vic-simkus/VIOBOARD_V1_Schematics/README.md

# VIOBOARD_V1_Schematics
Schematics for VIOBOAD Version 1.0
