vic-simkus/VIOBOARD_V1_Schematics/BBB_SHIELD_V2/BBB_SHIELD_V2_bom.ods

Sheet: BBB_SHIELD_V2_bom
Description | References | Value | QTY | MFGPN | DKPN
Polarized capacitor | C46 C47 C48 | 180uF,50V | 3 | UPW1H181MPD | 493-1903-ND
Screw terminal, 01x02 | CONN5V5 | Scr Trm 01x02 | 1
Triode | D1 | 24V_TRIAC | 1 | ACTT6X-800E,127 | 1740-1006-ND
Fuse, small symbol | F1 | 24V_IN | 1 | 56000001319 | WK0001-ND
Connector, 01x06 | J2 J3 | Conn_01x06 | 2 | 22052061 | WM4104-ND
Connector, 01x10 | J4 | Conn_01x10 | 1
Connector, 01x04 | J1 | Scr Trm 01x04 | 1
Connector, 02x23 | P8 P9 | BBCONN | 2 |  | A26529-23-ND
VX78XX DC REGULATOR | P12V1 | VX78XX | 1 | VX7805-1000 | 102-4253-ND
VX78XX DC REGULATOR | P5V1 | VX78XX | 1 | VX78012-1000 | 102-4255-ND
N-MOSFET transistor | Q1 | Q_NMOS_GDS | 1 | PHP29N08T,127 | 1727-4645-ND
Push button switch | swP1 swR1 | SW_Push | 2

Sheet: MISC_SMD
DESC | REF |  | Q | MFG_PN | DK_PN
Quad Bilateral Switch | RS232SW | CD74HCx4066 | 2 | CD74HC4066M96 | 296-9224-1-ND
Shunt, adjustable | TL1 | 24V_REF | 1 | TL431BCLPR | 296-17374-1-ND
Current Shunt Monitor | U4 | INA138 | 1 | INA138NA/3K | 296-17936-1-ND
FET DRIVER | U1 | LTC7004 | 1 | LTC7004IMSE | LTC7004IMSE#PBF-ND
Op Amps | U5 | OPA340NA | 1 | OPA340NA/3K | 296-26275-1-ND
MCP1501 | VREF3V1 | SOT-23-6 | 1 | MCP1501T | MCP1501T-33E/CHYCT-ND
Dual RS232 | DRVA1 DRVB1 | MAX3232 | 2 | MAX3232ECDR | 296-19851-1-ND
PIC24FV | PIC1 | PIC24FVXXKA302 | 1 | PIC24FV32KA302 | PIC24FV32KA302-I/SO-ND

Sheet: SMD_DIODE
 | FP | C | MFG PN | DK PN
D9 D10 D11 | COMCHIP_TO_277 | 3 | CDBZ310200-HF | 641-1494-1-ND
D2(TVS) | DO-214AA | 1 | SMBJ26A | SMBJ26ALFCT-ND
D3 | D_SOD-123F | 1 | RF071MM2STR | RF071MM2SCT-ND
D4 D5 D6 D7 D8 LED1 | LED_0805 | 6

Sheet: SMD_CAPS
 | V | F | C | TC | E
C7 C11 C15 C19 | 0.01uF | 0805 | 4 | X7R | 50
C1 C8 C12 C16 C20 C23 C24 C25 C26 C27 C28 C29 C30 C31 C32 | 0.1uF | 0805 | 15 | X7R | 50
C6 C10 C14 C18 C22 | 10uF | 0805 | 5 | X5R | 10
C3 C33 C34 C35 C36 C39 C40 C41 C42 | 10uF | 1206 | 9 | X7R | 50
C2 C4 C5 C9 C13 C17 C21 C45 C49 | 1uF | 0805 | 9 | X7R | 50
C37 C38 C43 C44 | 2.2uF | 1206 | 4 | X5R | 50

Sheet: SMD_RES
 | V | F | C
R9 R10 R13 | 10K | 0805 | 3
R1 R2 R3 R4 R5 R23 | 1K | 0805 | 6
R11 R12 R14 R15 R16 R17 R21 R22 R25 R26 | 200R | 0805 | 10
R6 R24 (0603) | 49K9 | 0805 | 2
R7 R8 R18 R19 R20 | 4K7 | 0805 | 5
RSHUNT1 | 0.01 | 1206 | 1
