vic-simkus/VIOBOARD_V1_Schematics/BBB_SHIELD/SHIELD_CUTLINES_SERIAL_MM_exp.dxf

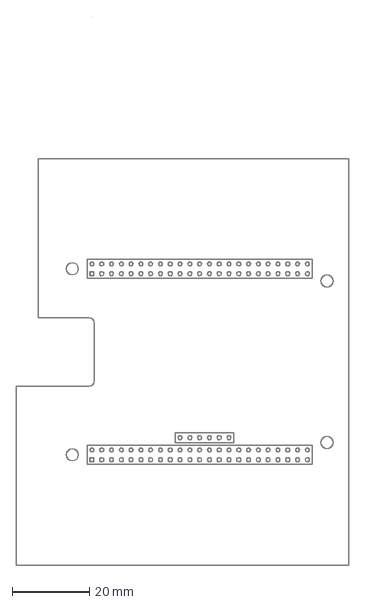
[picture p3: CAD file, 2018-09-03, an earlier design]
BBB_SHIELD/SHIELD_CUTLINES_SERIAL_MM_exp.dxf
86.4 x 142.4 mm
