vic-simkus/VIOBOARD_V1_Schematics/BBB_SHIELD/SHIELD_CUTLINES_SERIAL_MM.dxf

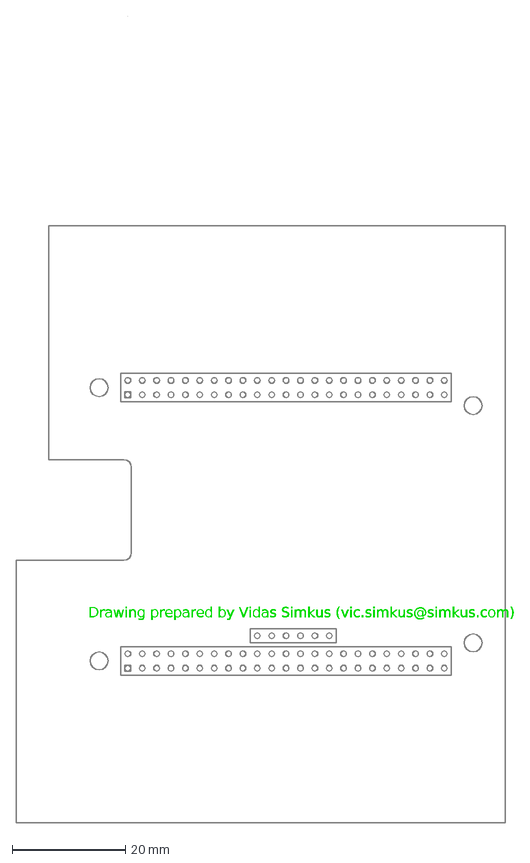
[picture p5: CAD file, 2018-09-03, an earlier design]
BBB_SHIELD/SHIELD_CUTLINES_SERIAL_MM.dxf
Drawing prepared by Vidas Simkus (vic.simkus@simkus.com)
