vic-simkus/VIOBOARD_V1_Schematics/BBB_SHIELD_V2/PLOT_3.0/BBB_SHIELD_V2.pdf

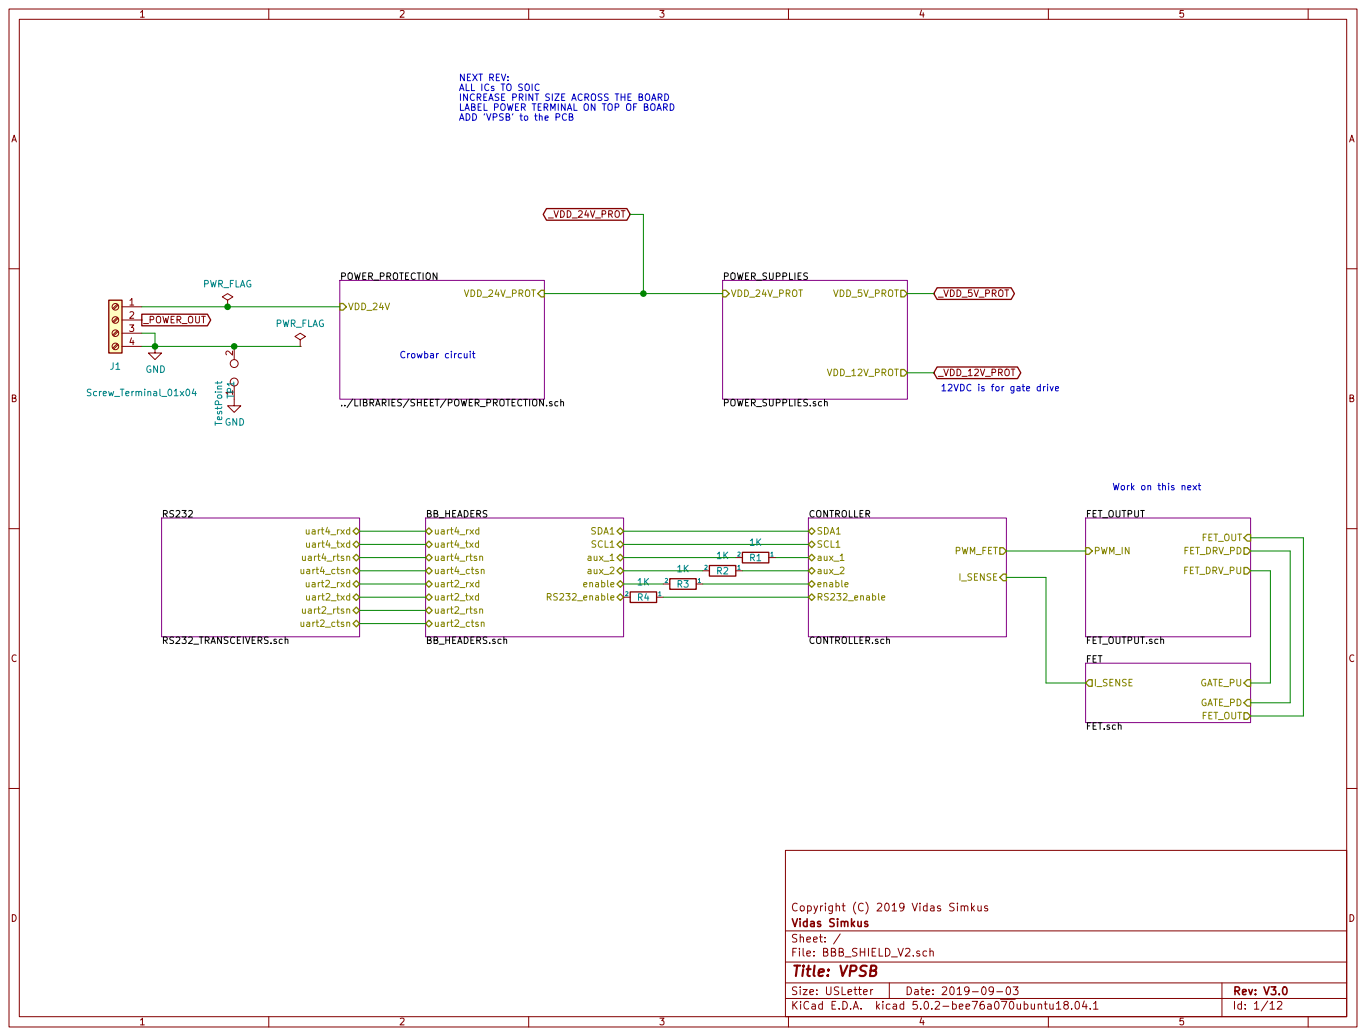
[picture p6: page 1]

NEXT REV: ALL ICs TO SOIC
INCREASE PRINT SIZE ACROSS THE BOARD
LABEL POWER TERMINAL ON TOP OF BOARD
ADD 'VPSB' to the PCB

File: BBB_SHIELD_V2.sch Sheet: / Vidas Simkus Copyright (C) 2019 Vidas Simkus

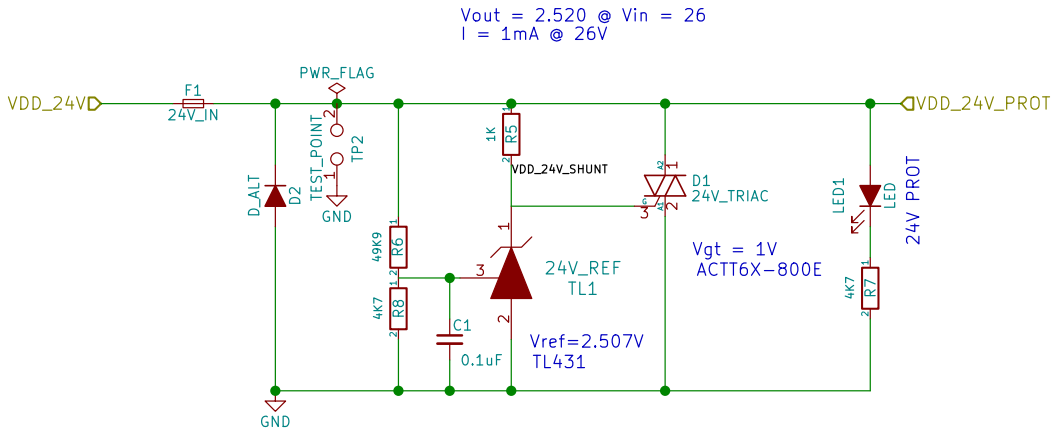
[picture p7: page 2]

Sheet: /POWER_PROTECTION/ Vidas Simkus Copyright (C) 2019 Vidas Simkus

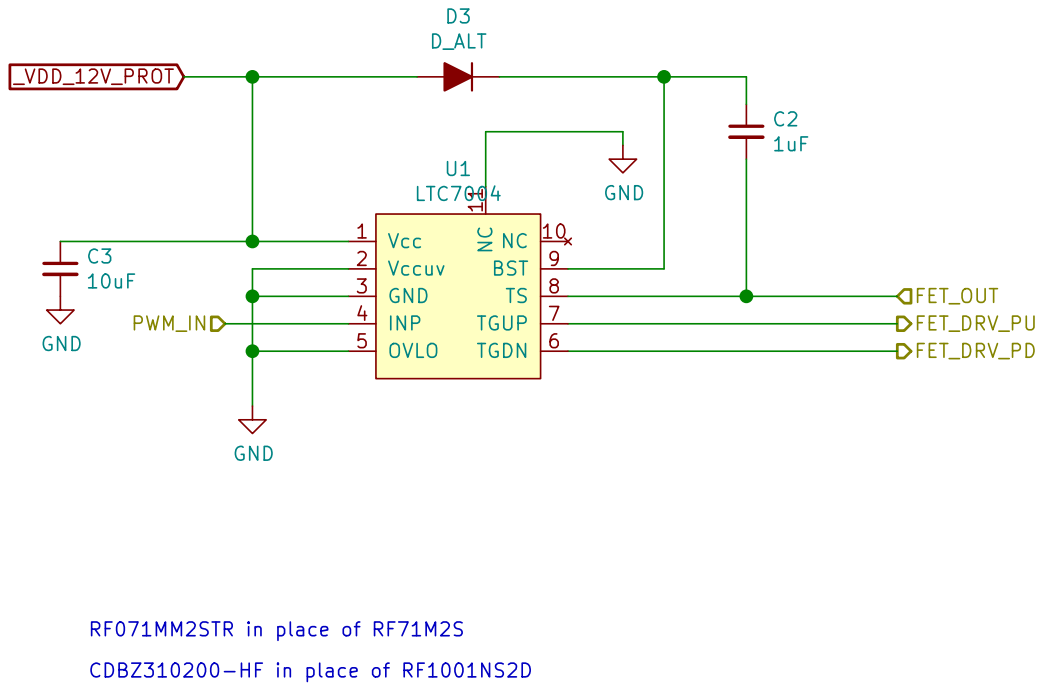
[picture p8: page 3]

RF071MM2STR in place of RF71M2S
CDBZ310200-HF in place of RF1001NS2D

Sheet: /FET_OUTPUT/ Vidas Simkus Copyright (C) 2019 Vidas Simkus

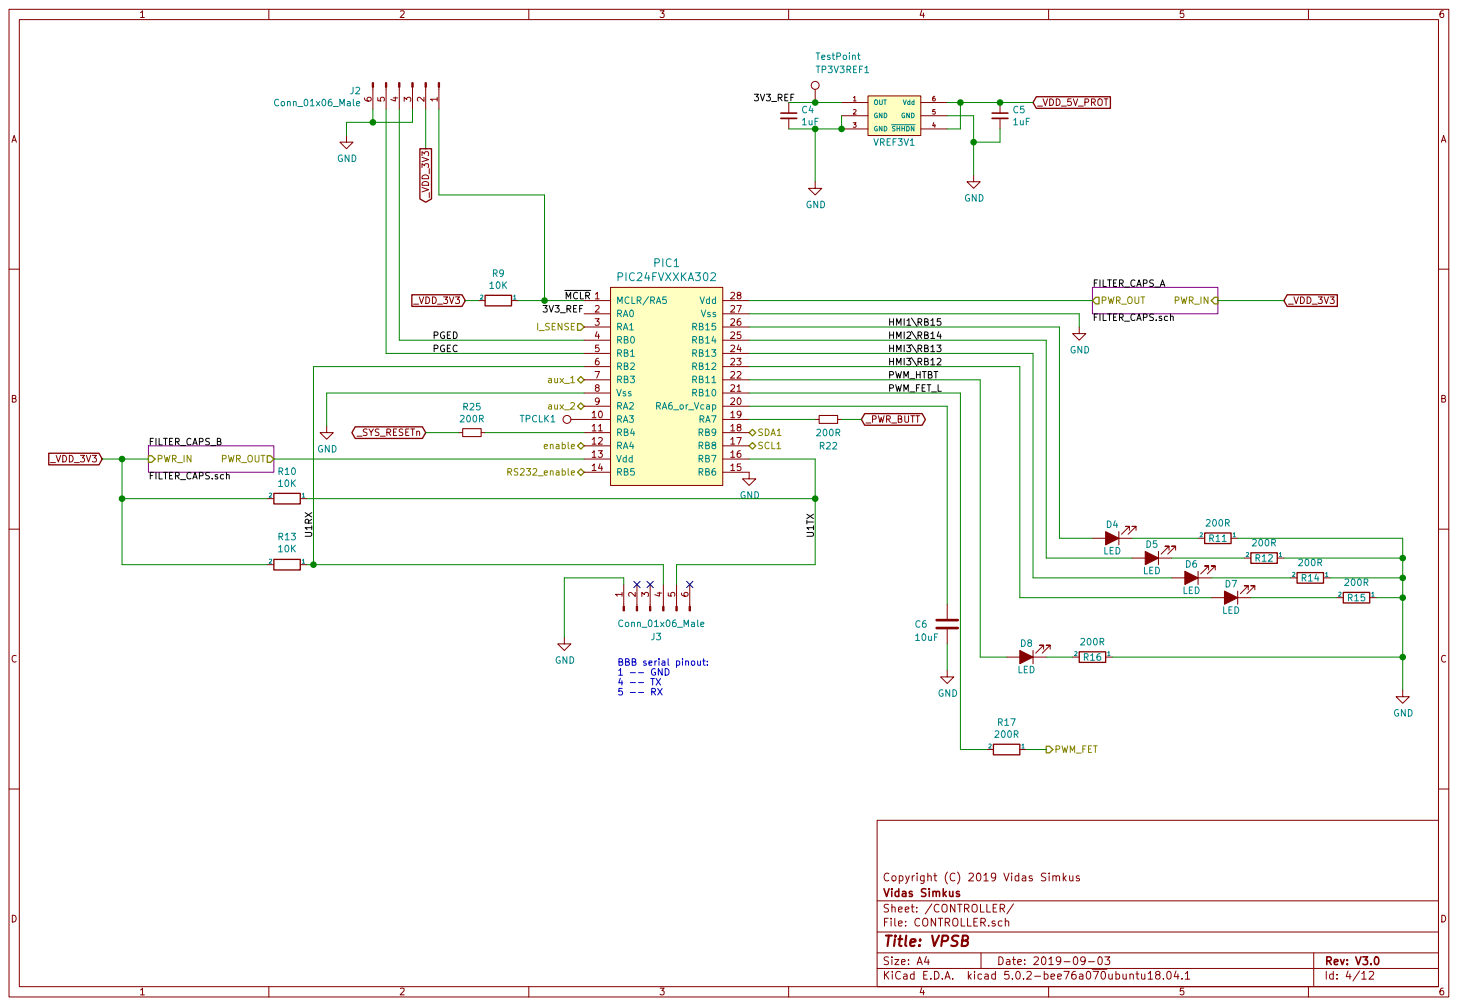
[picture p9: page 4]

BBB serial pinout: 1 -- GND

File: CONTROLLER.sch Sheet: /CONTROLLER/ Vidas Simkus Copyright (C) 2019 Vidas Simkus

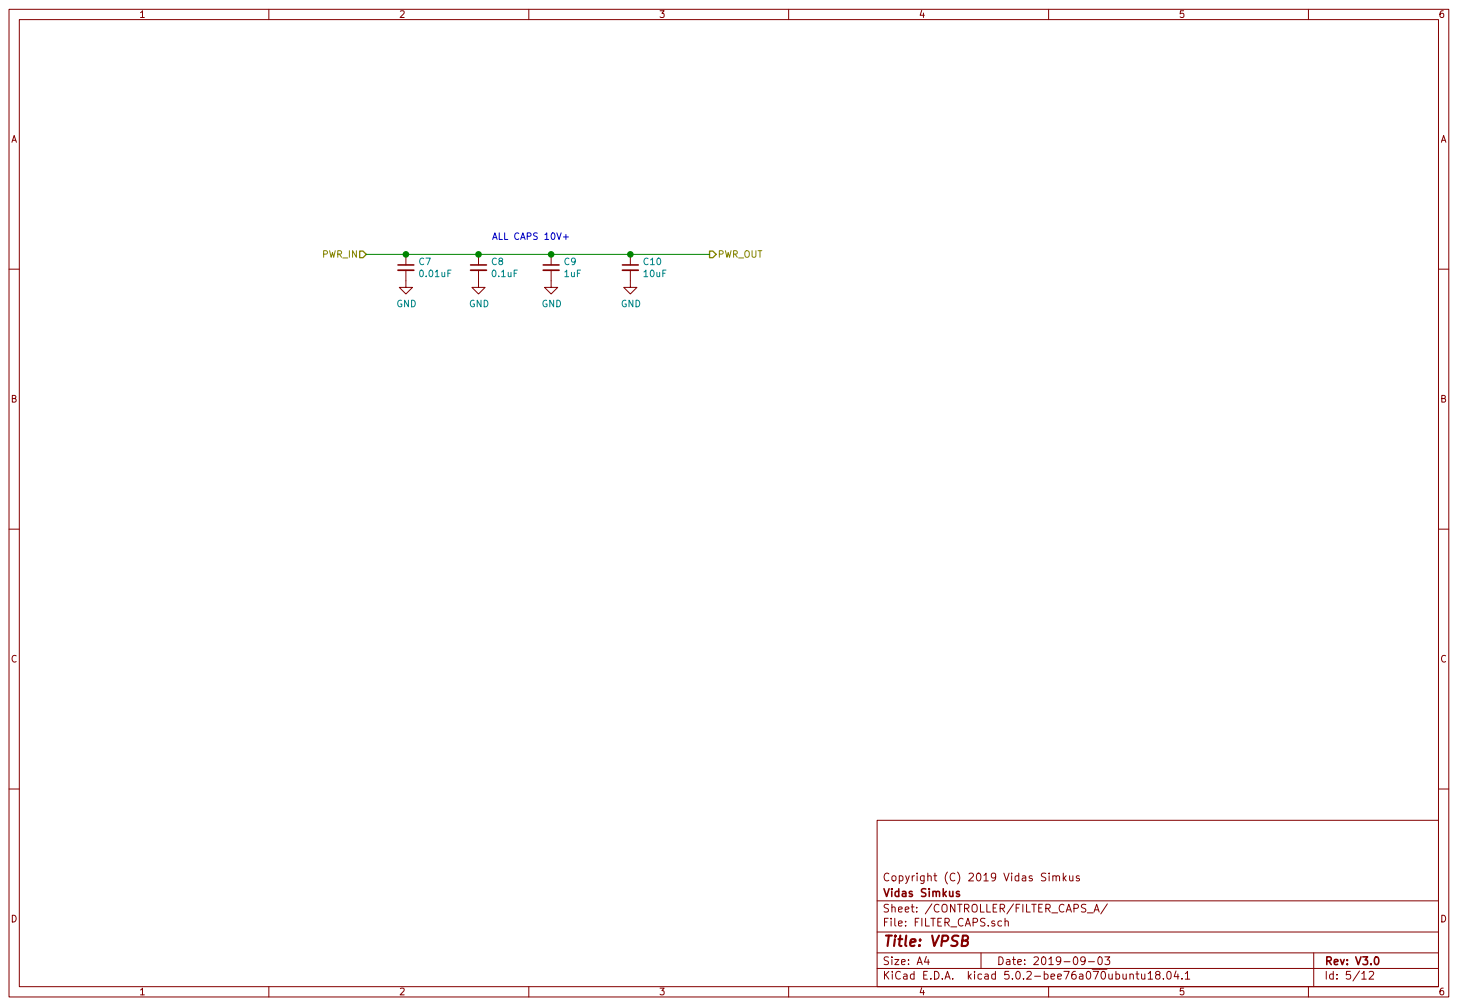
[picture p10: page 5]

Sheet: /CONTROLLER/FILTER_CAPS_A/ Vidas Simkus Copyright (C) 2019 Vidas Simkus

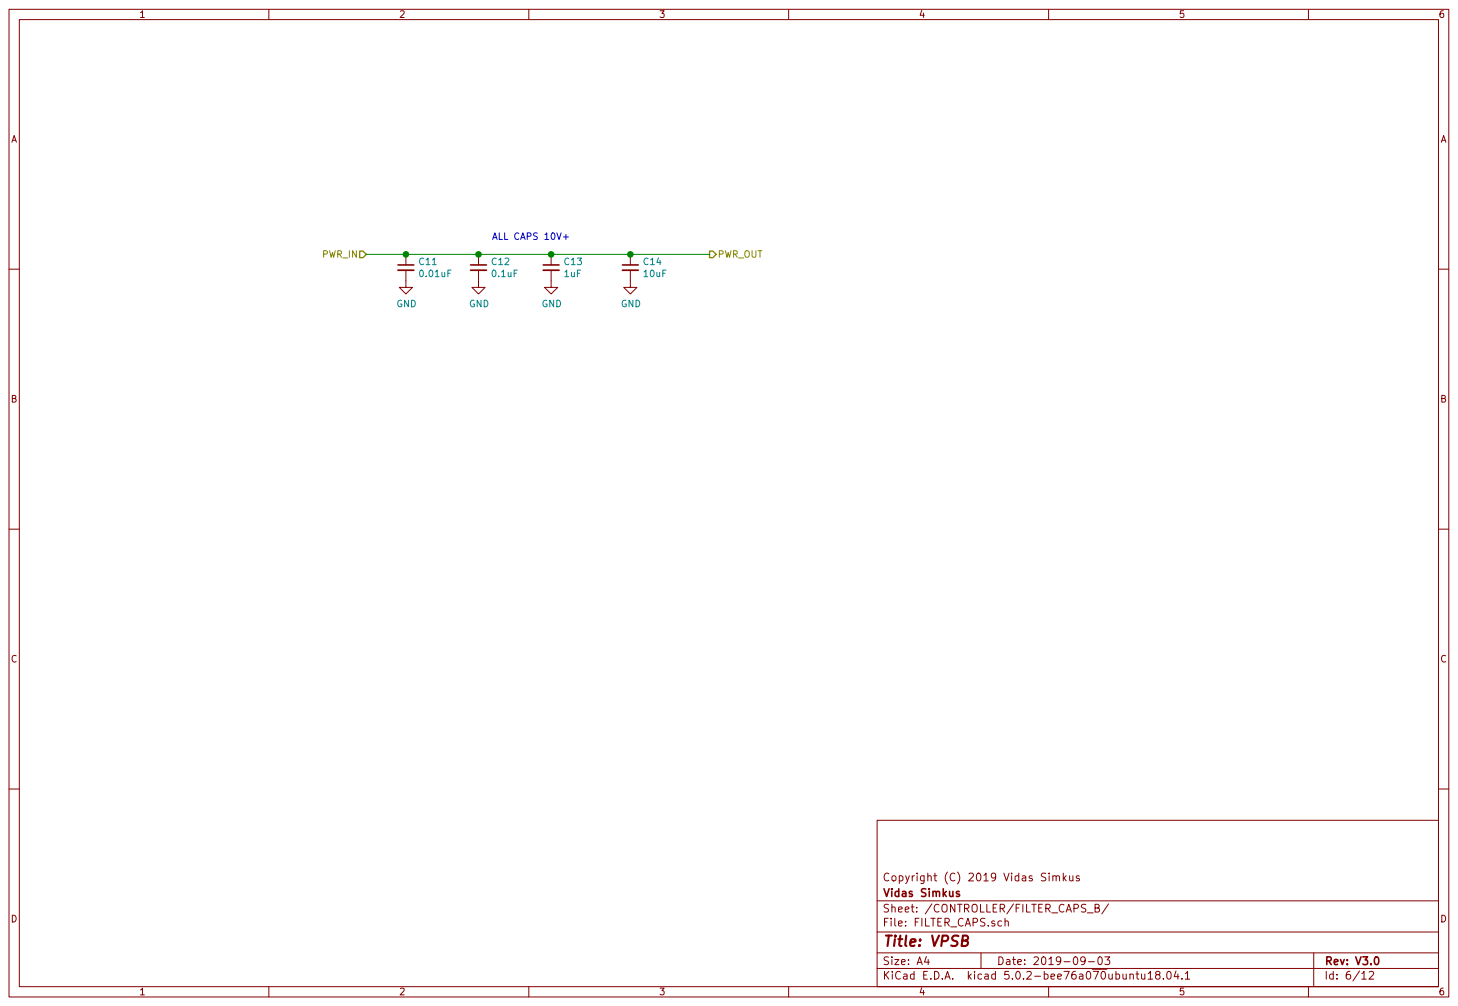
[picture p11: page 6]

Sheet: /CONTROLLER/FILTER_CAPS_B/ Vidas Simkus Copyright (C) 2019 Vidas Simkus

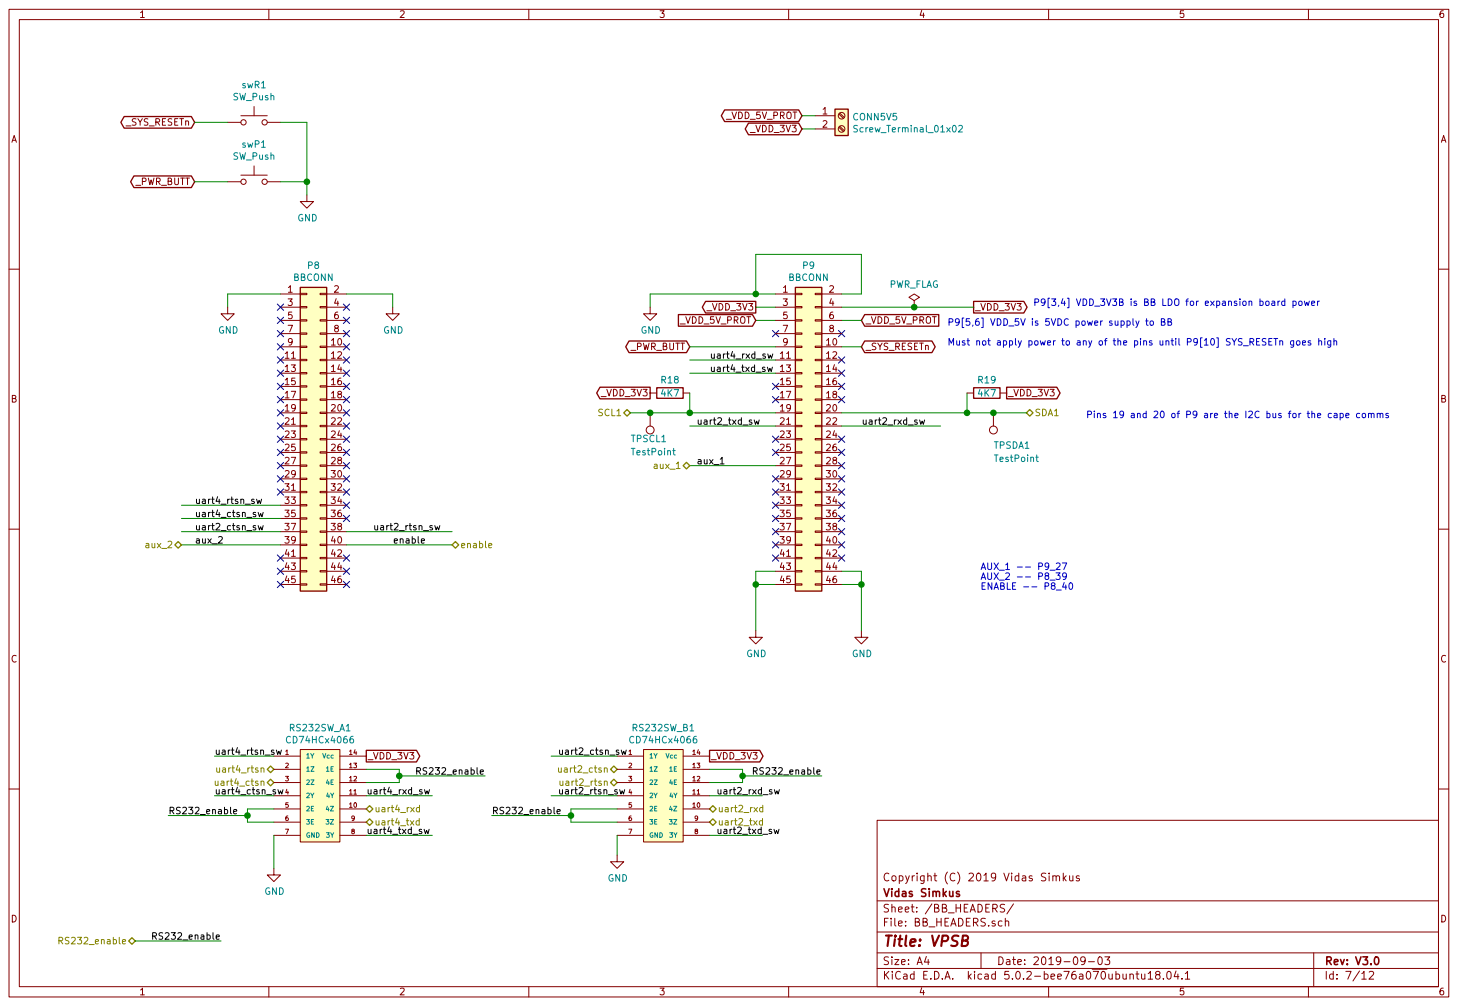
[picture p12: page 7]

P9[5,6] VDD_5V is 5VDC power supply to BB

Sheet: /BB_HEADERS/ Vidas Simkus Copyright (C) 2019 Vidas Simkus

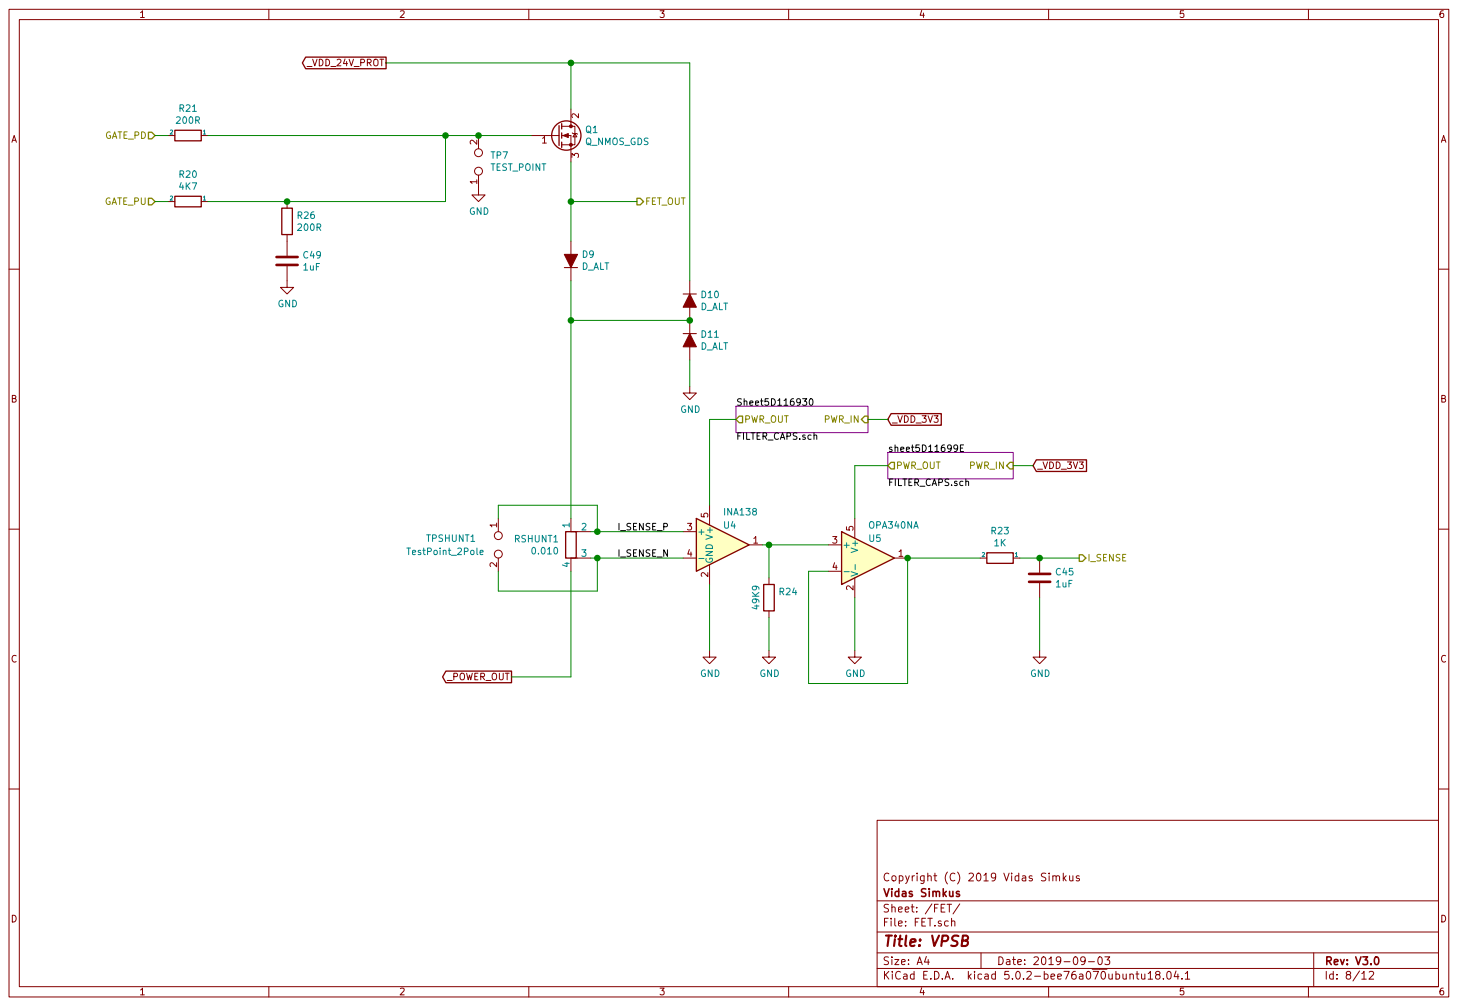
[picture p13: page 8]

File: FET.sch Sheet: /FET/ Vidas Simkus Copyright (C) 2019 Vidas Simkus

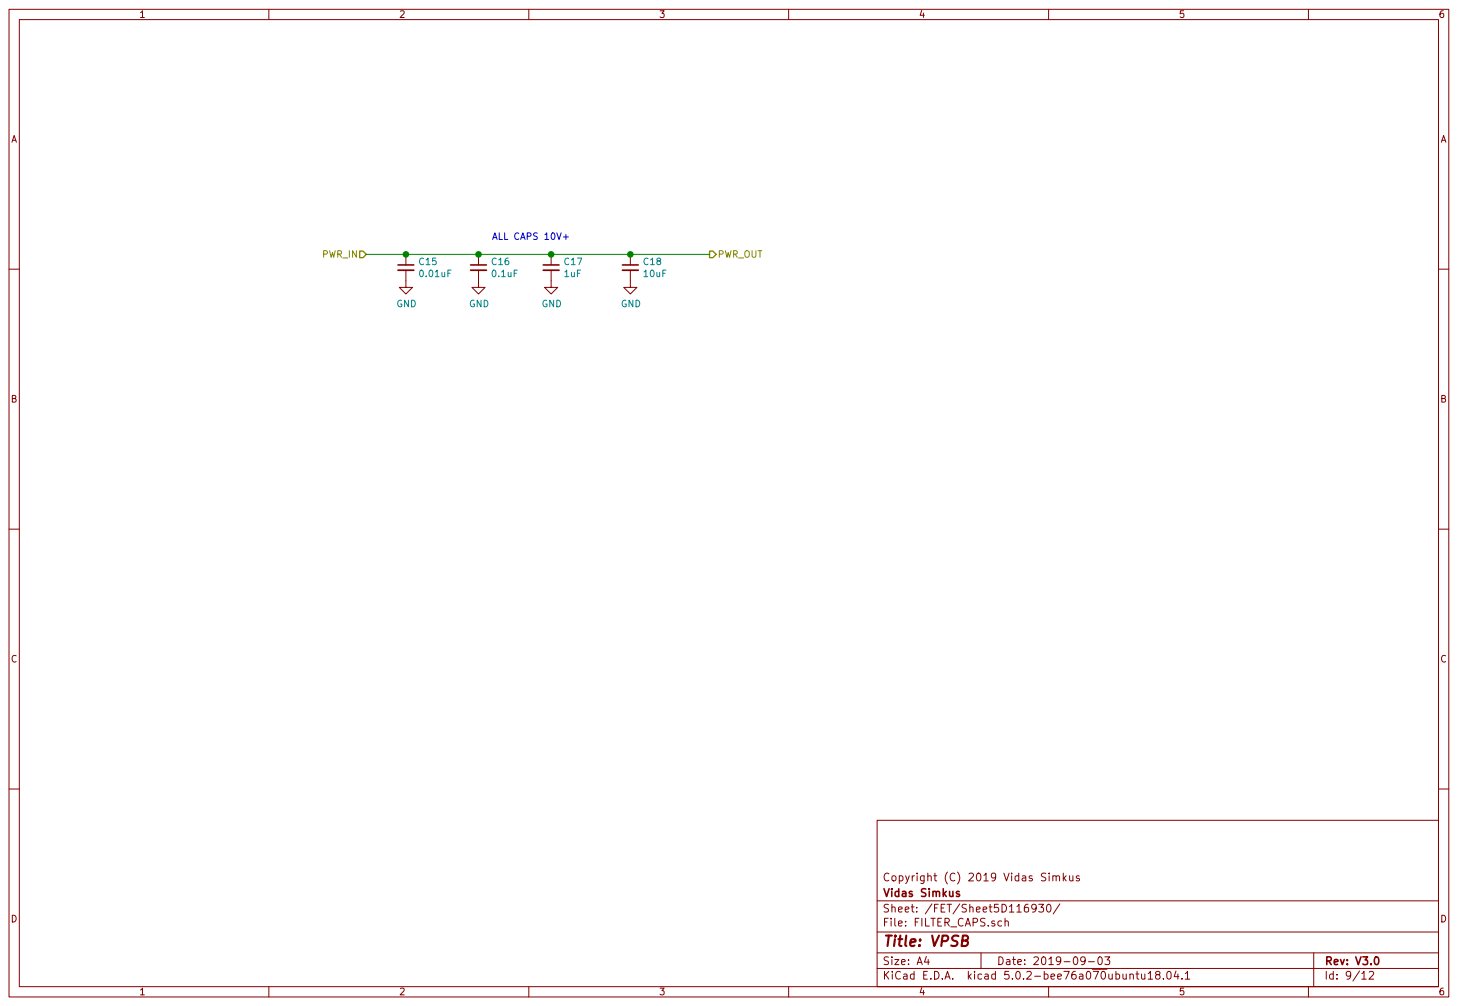
[picture p14: page 9]

File: FILTER_CAPS.sch Sheet: /FET/Sheet5D116930/ Vidas Simkus Copyright (C) 2019 Vidas Simkus

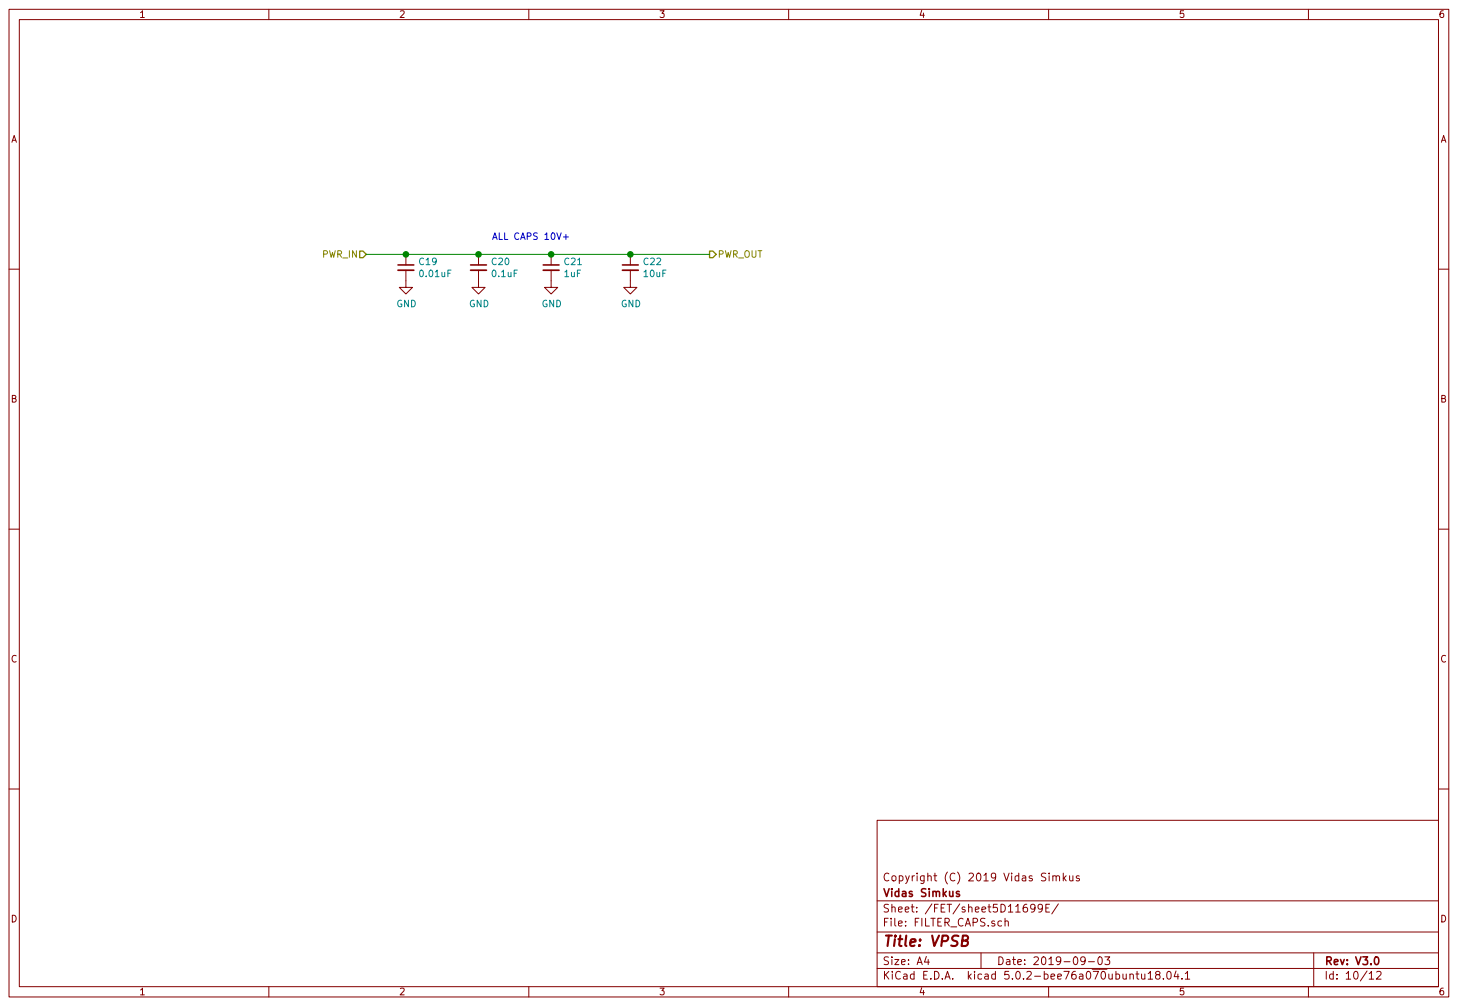
[picture p15: page 10]

File: FILTER_CAPS.sch Sheet: /FET/sheet5D11699E/ Vidas Simkus Copyright (C) 2019 Vidas Simkus

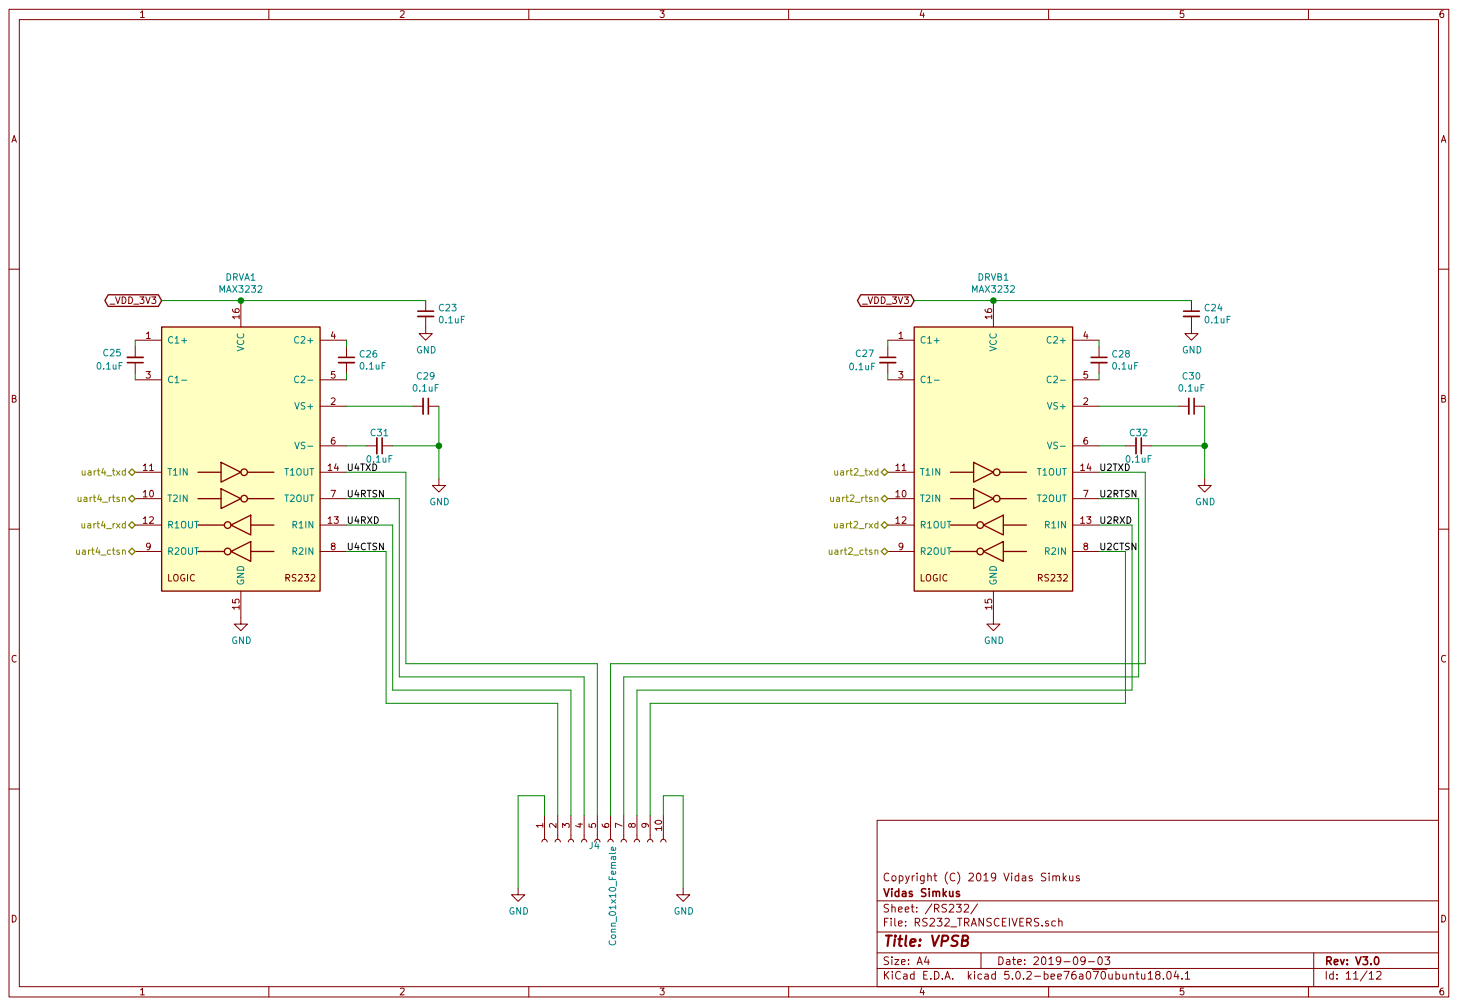
[picture p16: page 11]

File: RS232_TRANSCEIVERS.sch Sheet: /RS232/ Vidas Simkus Copyright (C) 2019 Vidas Simkus

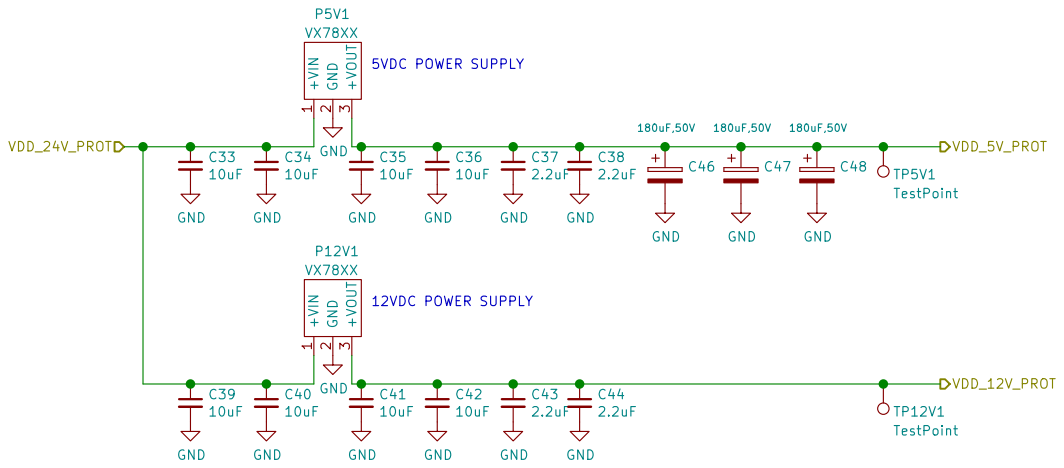
[picture p17: page 12]

2 +VOUT
Sheet: /POWER_SUPPLIES/ Vidas Simkus Copyright (C) 2019 Vidas Simkus +VIN
