vic-simkus/VIOBOARD_V1_Schematics/BBB_SHIELD_V2/BBB_SHIELD_V2.kicad_pcb

## KiCad design BBB_SHIELD_V2/BBB_SHIELD_V2.kicad_pcb (2019-09-24)

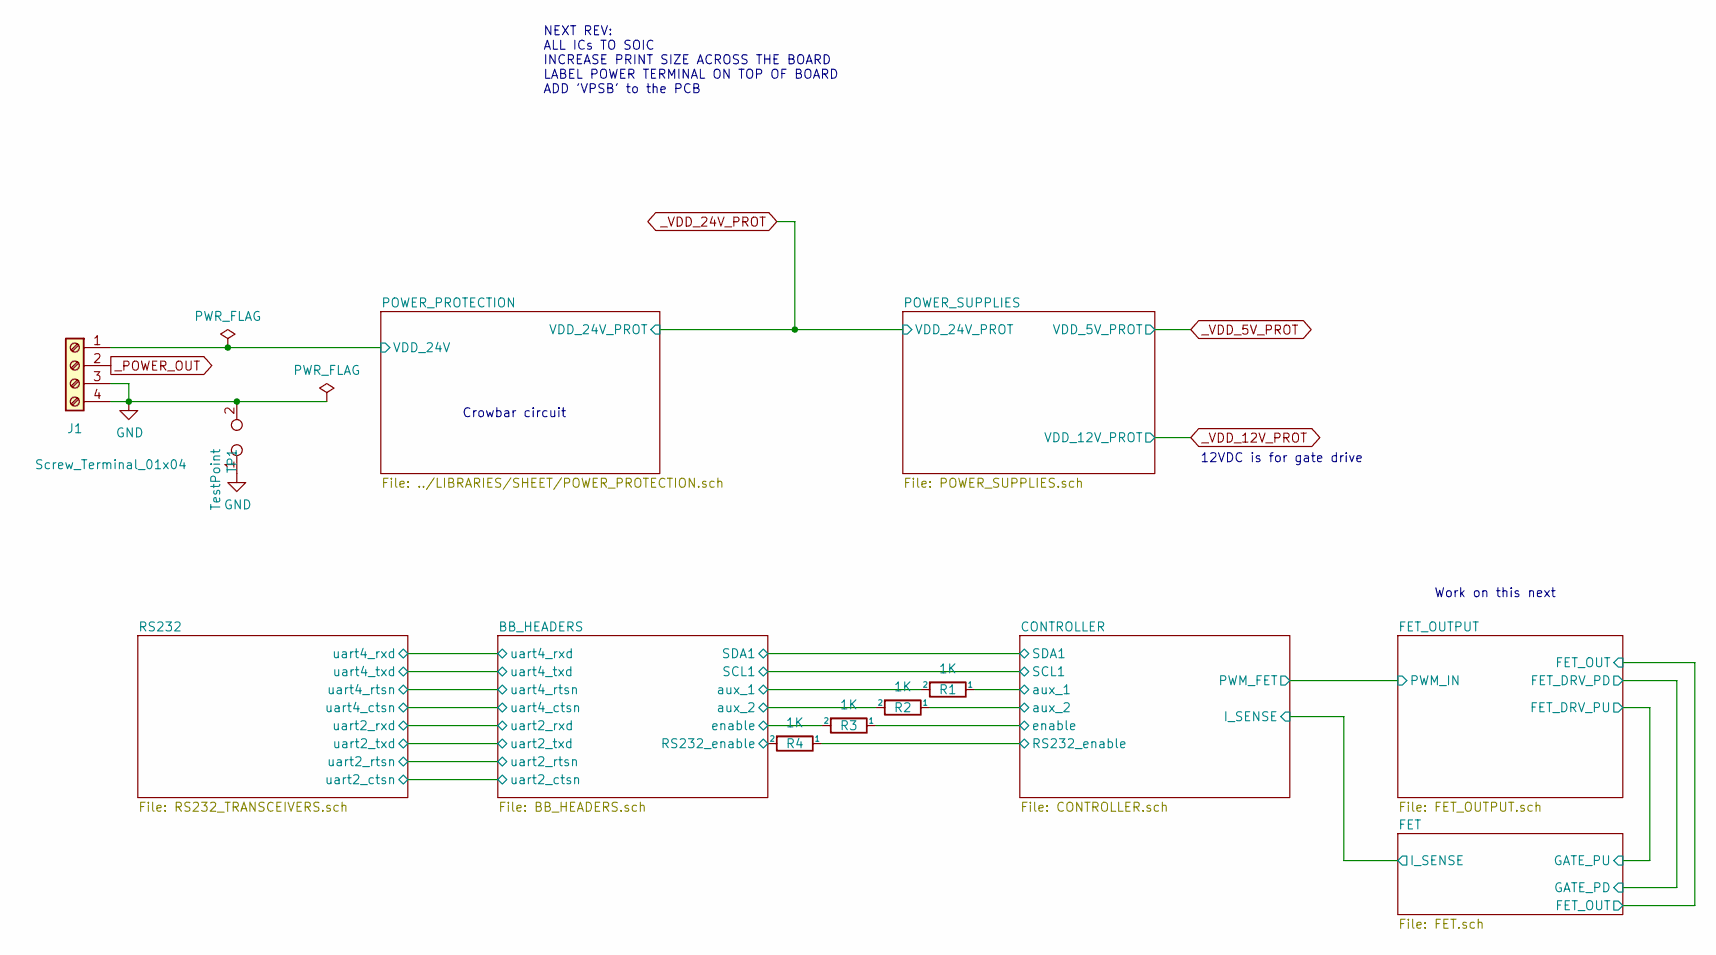
[picture p18: schematic BBB_SHIELD_V2.sch, VPSB]

Parts:
J1: Screw_Terminal_01x04; OSTTA044163
R1, R2, R3, R4: 1K; R_0805_2012Metric; MFGPN CRCW08051K00FKEAC
TP1: TestPoint; PinHeader_1x02_P1.27mm_Vertical

Connections:
/BB_HEADERS/RS232_enable: R4.2; also elsewhere on the board
/BB_HEADERS/aux_1: R1.2; also elsewhere on the board
/BB_HEADERS/aux_2: R2.2; also elsewhere on the board
/BB_HEADERS/enable: R3.2; also elsewhere on the board
/CONTROLLER/RS232_enable: R4.1; also elsewhere on the board
/CONTROLLER/aux_1: R1.1; also elsewhere on the board
/CONTROLLER/aux_2: R2.1; also elsewhere on the board
/CONTROLLER/enable: R3.1; also elsewhere on the board
/POWER_PROTECTION/VDD_24V: J1.1; also elsewhere on the board
GND: J1.3, J1.4, TP1.1, TP1.2; also elsewhere on the board
_POWER_OUT: J1.2; also elsewhere on the board

Notes on the sheet:
NEXT REV: ALL ICs TO SOIC INCREASE PRINT SIZE ACROSS THE BOARD LABEL POWER TERMINAL ON TOP OF BOARD ADD 'VPSB' to the PCB
12VDC is for gate drive
Crowbar circuit
Work on this next

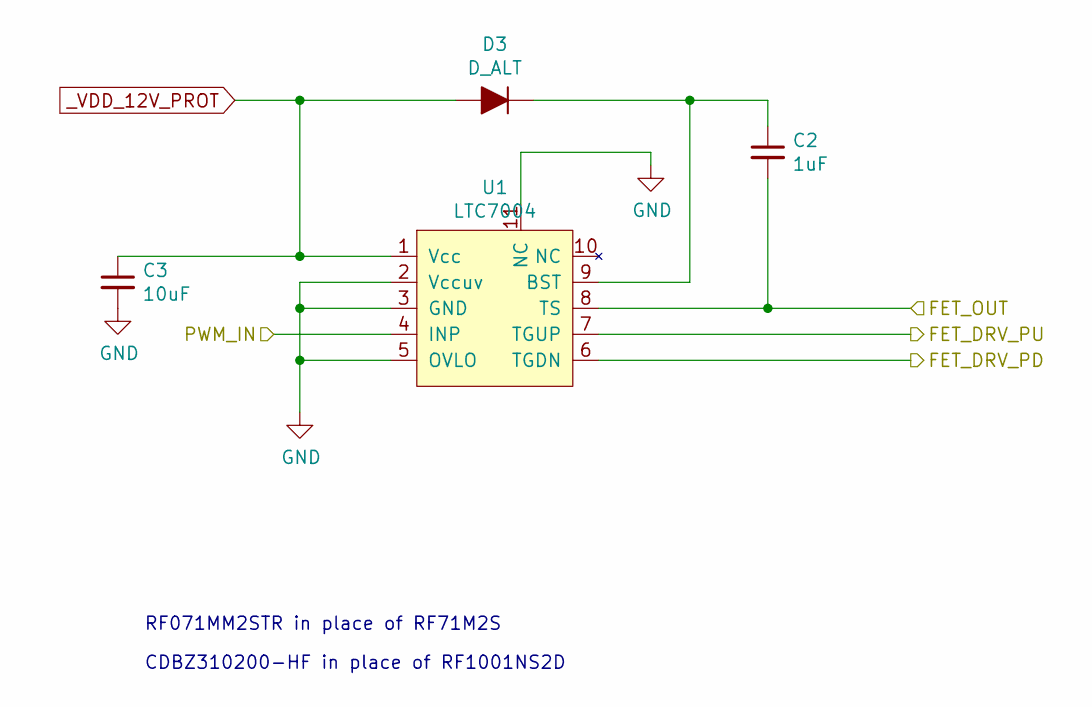
[picture p19: schematic FET_OUTPUT.sch, VPSB]

Parts:
C2: 1uF; C_0805_2012Metric; VOLTAGE 50; MFGPN CL21B104KBCNNNC
C3: 10uF; C_1206_3216Metric; VOLTAGE 50; MFGPN CL31B106KBHNNNE
D3: D_ALT; D_SOD-123F; MFGPN RF071MM2STR
U1: LTC7004; MSOP-10; MFGPN LTC7004IMSE#PBF

Connections:
/CONTROLLER/PWM_FET: U1.4 (INP); also elsewhere on the board
/FET/FET_OUT: C2.2, U1.8 (TS); also elsewhere on the board
/FET_OUTPUT/FET_DRV_PD: U1.6 (TGDN); also elsewhere on the board
/FET_OUTPUT/FET_DRV_PU: U1.7 (TGUP); also elsewhere on the board
GND: C3.2, U1.2 (Vccuv), U1.3 (GND), U1.5 (OVLO), U1.11 (NC); also elsewhere on the board
unnamed: C2.1, D3.1 (K), U1.9 (BST)
_VDD_12V_PROT: C3.1, D3.2 (A), U1.1 (Vcc); also elsewhere on the board

Notes on the sheet:
‎RF071MM2STR‎ in place of RF71M2S
CDBZ310200-HF in place of RF1001NS2D

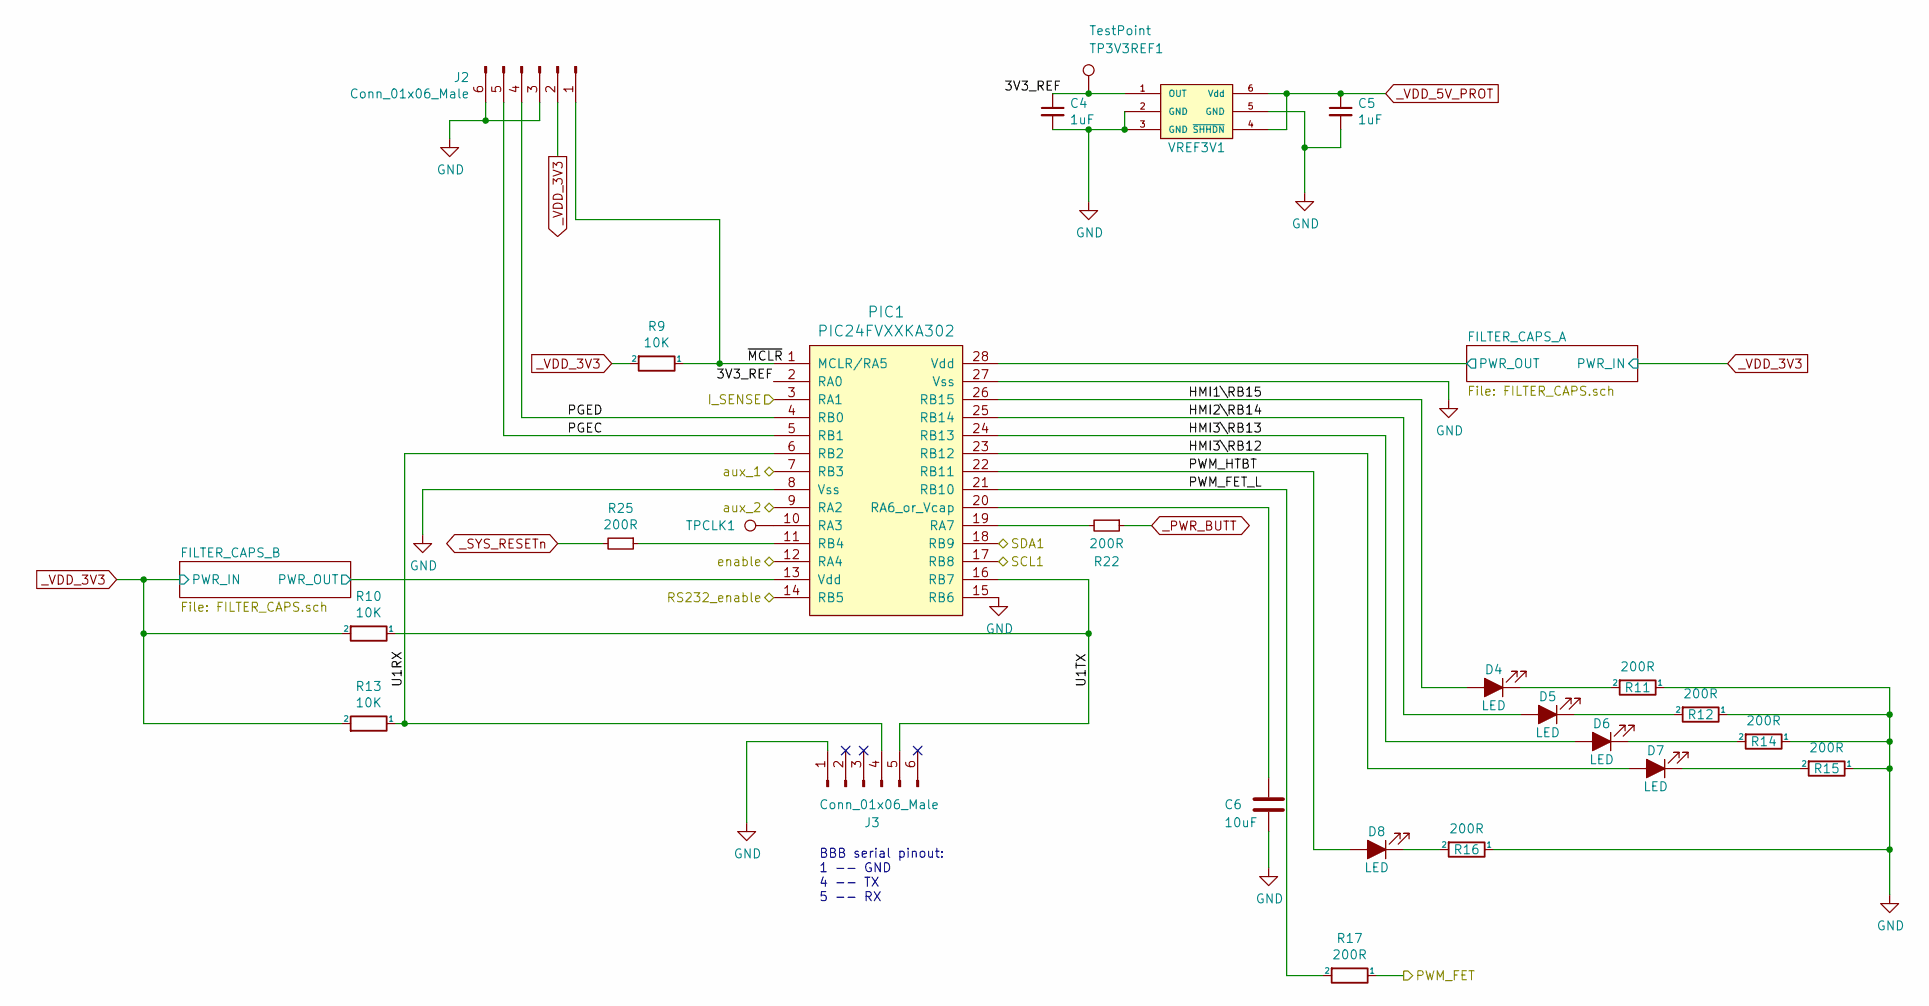
[picture p20: schematic CONTROLLER.sch, VPSB]

Parts:
C4, C5: 1uF; C_0805_2012Metric; VOLTAGE 50; MFGPN CL21B105KBFNFNE
C6: 10uF; C_0805_2012Metric; VOLTAGE 10; MFGPN CL21A106KPFNNNE
D4, D5, D6, D7, D8: LED; LED_0805_2012Metric_Castellated; VOLTAGE NA
J2, J3: Conn_01x06_Male; PinHeader_1x06_P2.54mm_Horizontal; MFGPN 0022052061
PIC1: PIC24FVXXKA302; SOIC-28W_7.5x17.9mm_P1.27mm; MFGPN PIC24FV32KA302-I/SO
R9, R10, R13: 10K; R_0805_2012Metric; MFGPN CRCW080510K0FKTA
R11, R12, R14, R15, R16, R17, R22, R25: 200R; R_0805_2012Metric; MFGPN CRCW0805200RFKEAC
TP3V3REF1: TestPoint; TestPoint_THTPad_D1.0mm_Drill0.5mm
TPCLK1: TestPoint; TestPoint_THTPad_D1.0mm_Drill0.5mm
VREF3V1: MCP1501_SOT-23-6; SOT-23-6; MFGPN MCP1501T-33E/CHY

Connections:
/BB_HEADERS/SCL1: PIC1.17 (RB8); also elsewhere on the board
/BB_HEADERS/SDA1: PIC1.18 (RB9); also elsewhere on the board
/CONTROLLER/3V3_REF: C4.1, PIC1.2 (RA0), TP3V3REF1.1, VREF3V1.1 (OUT)
/CONTROLLER/HMI1\RB15: D4.2 (A), PIC1.26 (RB15)
/CONTROLLER/HMI2\RB14: D5.2 (A), PIC1.25 (RB14)
/CONTROLLER/HMI3\RB12: D7.2 (A), PIC1.23 (RB12)
/CONTROLLER/HMI3\RB13: D6.2 (A), PIC1.24 (RB13)
/CONTROLLER/I_SENSE: PIC1.3 (RA1); also elsewhere on the board
/CONTROLLER/PGEC: J2.5, PIC1.5 (RB1)
/CONTROLLER/PGED: J2.4, PIC1.4 (RB0)
/CONTROLLER/PWM_FET: R17.1; also elsewhere on the board
/CONTROLLER/PWM_FET_L: PIC1.21 (RB10), R17.2
/CONTROLLER/PWM_HTBT: D8.2 (A), PIC1.22 (RB11)
/CONTROLLER/RS232_enable: PIC1.14 (RB5); also elsewhere on the board
/CONTROLLER/U1RX: J3.4, PIC1.6 (RB2), R13.1
/CONTROLLER/U1TX: J3.5, PIC1.16 (RB7), R10.1
/CONTROLLER/aux_1: PIC1.7 (RB3); also elsewhere on the board
/CONTROLLER/aux_2: PIC1.9 (RA2); also elsewhere on the board
/CONTROLLER/enable: PIC1.12 (RA4); also elsewhere on the board
/CONTROLLER/~MCLR: J2.1, PIC1.1 (MCLR/RA5), R9.1
GND: C4.2, C5.2, C6.2, J2.3, J2.6, J3.1, PIC1.8 (Vss), PIC1.15 (RB6), PIC1.27 (Vss), R11.1, R12.1, R14.1, R15.1, R16.1, VREF3V1.2 (GND), VREF3V1.3 (GND), VREF3V1.5 (GND); also elsewhere on the board
unnamed: C6.1, PIC1.20 (RA6_or_Vcap)
unnamed: D4.1 (K), R11.2
unnamed: D5.1 (K), R12.2
unnamed: D6.1 (K), R14.2
unnamed: D7.1 (K), R15.2
unnamed: D8.1 (K), R16.2
unnamed: PIC1.10 (RA3), TPCLK1.1
unnamed: PIC1.11 (RB4), R25.1
unnamed: PIC1.19 (RA7), R22.2
_PWR_BUTT: R22.1; also elsewhere on the board
_SYS_RESETn: R25.2; also elsewhere on the board
_VDD_3V3: J2.2, PIC1.13 (Vdd), PIC1.28 (Vdd), R9.2, R10.2, R13.2; also elsewhere on the board
_VDD_5V_PROT: C5.1, VREF3V1.4 (~SHHDN), VREF3V1.6 (Vdd); also elsewhere on the board

Notes on the sheet:
BBB serial pinout: 1 -- GND 4 -- TX 5 -- RX

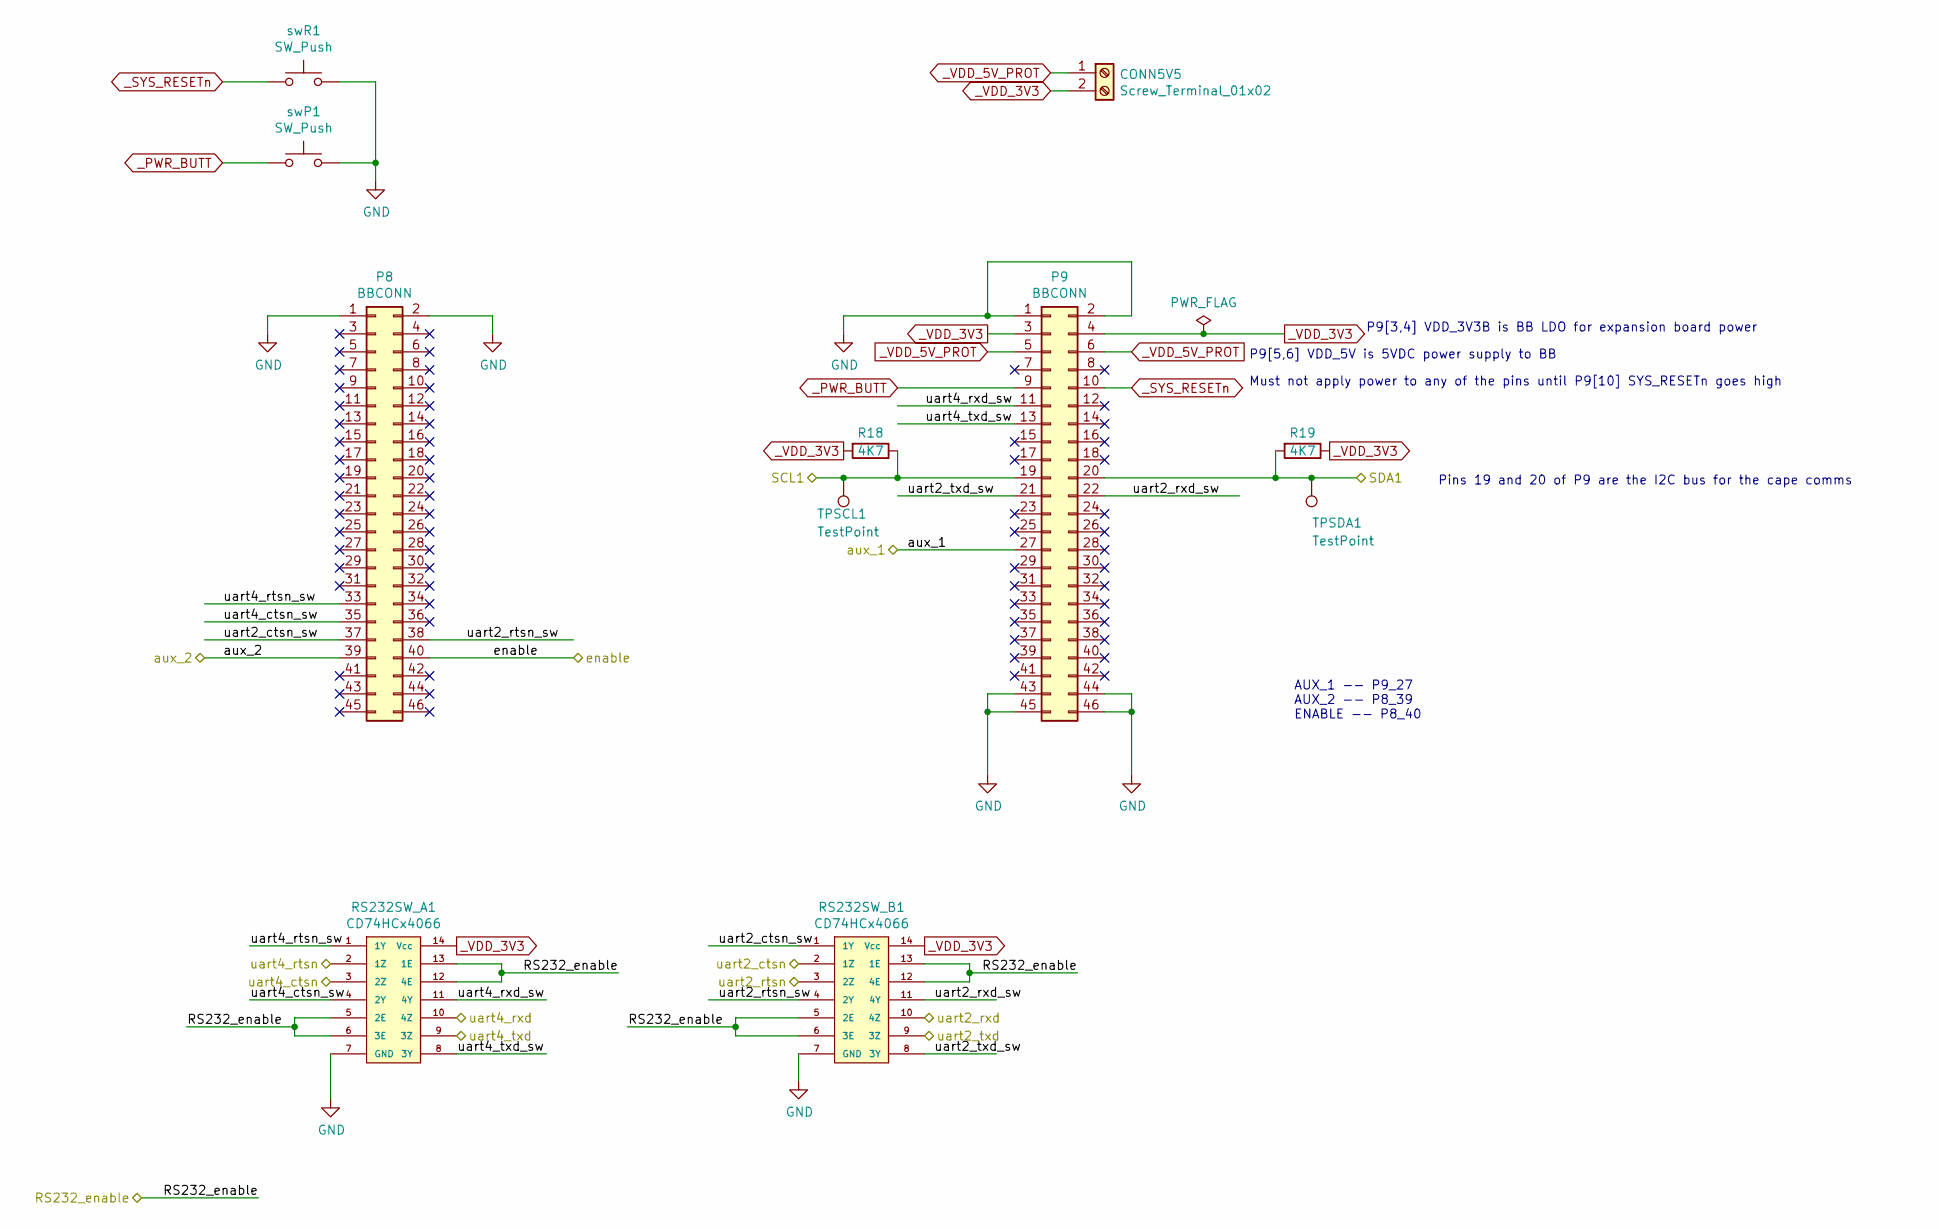
[picture p21: schematic BB_HEADERS.sch, VPSB]

Parts:
CONN5V5: Screw_Terminal_01x02; OSTTA024163
P8, P9: BBCONN; PinHeader_2x23_P2.54mm_Vertical
R18, R19: 4K7; R_0805_2012Metric; MFGPN CRCW08054K70FKEAC
RS232SW_A1, RS232SW_B1: CD74HCx4066; SOIC-14_3.9x8.7mm_P1.27mm; MFGPN CD74HC4066M96
TPSCL1: TestPoint; PinHeader_1x01_P1.27mm_Vertical
TPSDA1: TestPoint; PinHeader_1x01_P1.27mm_Vertical
swP1: SW_Push; SW_PUSH_6mm
swR1: SW_Push; SW_PUSH_6mm

Connections:
/BB_HEADERS/RS232_enable: RS232SW_A1.5 (2E), RS232SW_A1.6 (3E), RS232SW_A1.12 (4E), RS232SW_A1.13 (1E), RS232SW_B1.5 (2E), RS232SW_B1.6 (3E), RS232SW_B1.12 (4E), RS232SW_B1.13 (1E); also elsewhere on the board
/BB_HEADERS/SCL1: P9.19, R18.1, TPSCL1.1; also elsewhere on the board
/BB_HEADERS/SDA1: P9.20, R19.2, TPSDA1.1; also elsewhere on the board
/BB_HEADERS/aux_1: P9.27; also elsewhere on the board
/BB_HEADERS/aux_2: P8.39; also elsewhere on the board
/BB_HEADERS/enable: P8.40; also elsewhere on the board
/BB_HEADERS/uart2_ctsn: RS232SW_B1.2 (1Z); also elsewhere on the board
/BB_HEADERS/uart2_ctsn_sw: P8.37, RS232SW_B1.1 (1Y)
/BB_HEADERS/uart2_rtsn: RS232SW_B1.3 (2Z); also elsewhere on the board
/BB_HEADERS/uart2_rtsn_sw: P8.38, RS232SW_B1.4 (2Y)
/BB_HEADERS/uart2_rxd: RS232SW_B1.10 (4Z); also elsewhere on the board
/BB_HEADERS/uart2_rxd_sw: P9.22, RS232SW_B1.11 (4Y)
/BB_HEADERS/uart2_txd: RS232SW_B1.9 (3Z); also elsewhere on the board
/BB_HEADERS/uart2_txd_sw: P9.21, RS232SW_B1.8 (3Y)
/BB_HEADERS/uart4_ctsn: RS232SW_A1.3 (2Z); also elsewhere on the board
/BB_HEADERS/uart4_ctsn_sw: P8.35, RS232SW_A1.4 (2Y)
/BB_HEADERS/uart4_rtsn: RS232SW_A1.2 (1Z); also elsewhere on the board
/BB_HEADERS/uart4_rtsn_sw: P8.33, RS232SW_A1.1 (1Y)
/BB_HEADERS/uart4_rxd: RS232SW_A1.10 (4Z); also elsewhere on the board
/BB_HEADERS/uart4_rxd_sw: P9.11, RS232SW_A1.11 (4Y)
/BB_HEADERS/uart4_txd: RS232SW_A1.9 (3Z); also elsewhere on the board
/BB_HEADERS/uart4_txd_sw: P9.13, RS232SW_A1.8 (3Y)
GND: P8.1, P8.2, P9.1, P9.2, P9.43, P9.44, P9.45, P9.46, RS232SW_A1.7 (GND), RS232SW_B1.7 (GND), swP1.2, swR1.2; also elsewhere on the board
_PWR_BUTT: P9.9, swP1.1; also elsewhere on the board
_SYS_RESETn: P9.10, swR1.1; also elsewhere on the board
_VDD_3V3: CONN5V5.2, P9.3, P9.4, R18.2, R19.1, RS232SW_A1.14 (Vcc), RS232SW_B1.14 (Vcc); also elsewhere on the board
_VDD_5V_PROT: CONN5V5.1, P9.5, P9.6; also elsewhere on the board

Notes on the sheet:
P9[3,4] VDD_3V3B is BB LDO for expansion board power
P9[5,6] VDD_5V is 5VDC power supply to BB
Must not apply power to any of the pins until P9[10] SYS_RESETn goes high
Pins 19 and 20 of P9 are the I2C bus for the cape comms
AUX_1 -- P9_27 AUX_2 -- P8_39 ENABLE -- P8_40

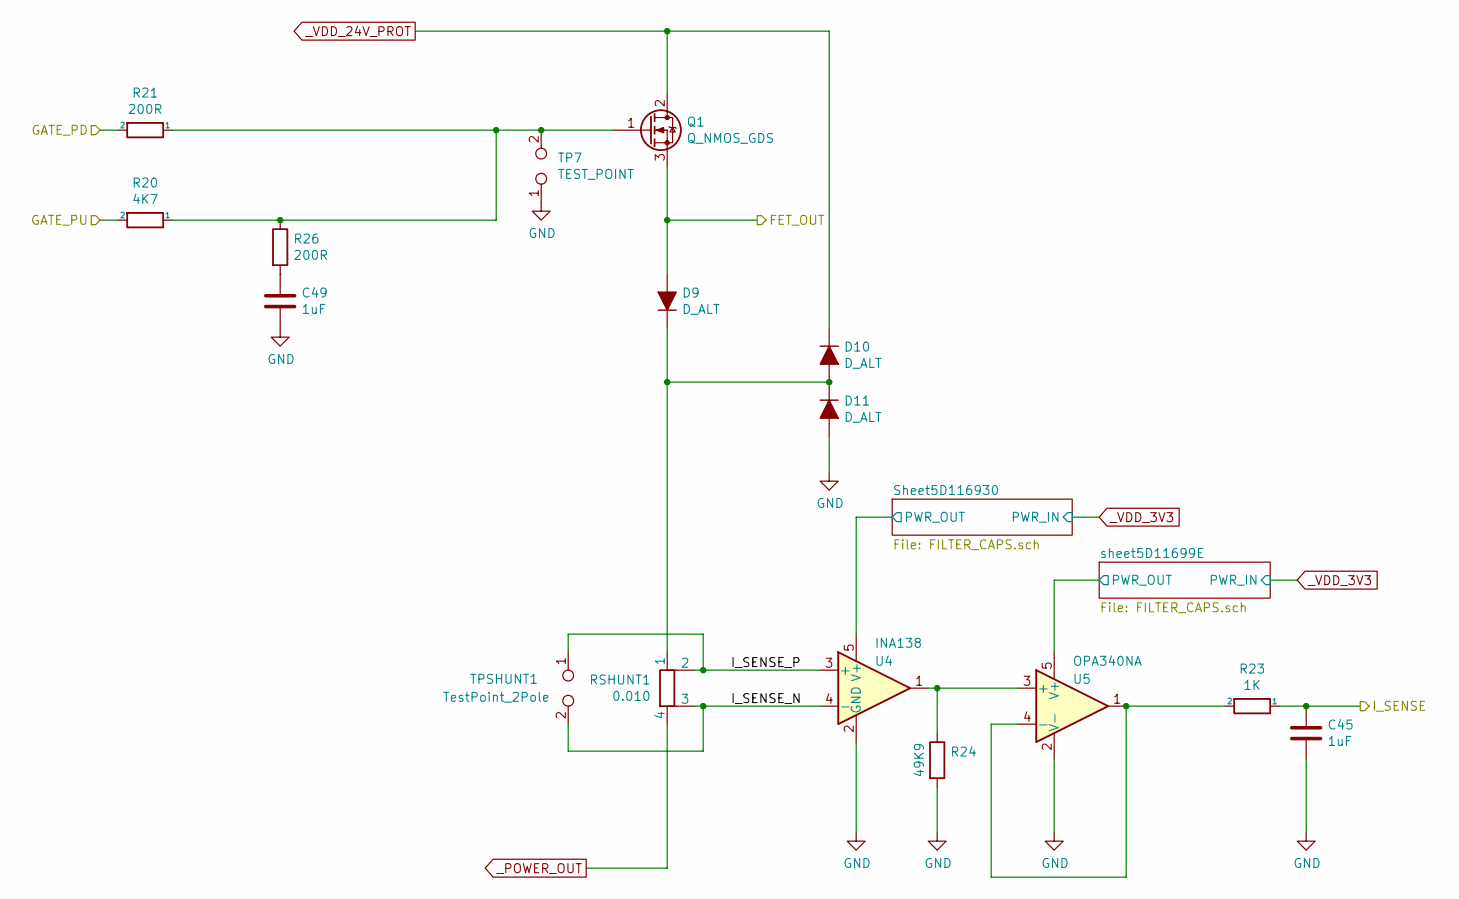
[picture p22: schematic FET.sch, VPSB]

Parts:
C45: 1uF; C_0805_2012Metric; VOLTAGE 50; MFGPN CL31A225KB9LNNC
C49: 1uF; C_0805_2012Metric
D9, D10, D11: D_ALT; COMCHIP_TO_277; MFGPN CDBZ310200-HF
Q1: Q_NMOS_GDS; TO-220-3_Vertical; MFGPN PHP29N08T,127
R20: 4K7; R_0805_2012Metric; MFGPN ERJ-P06F1000V
R21, R26: 200R; R_0805_2012Metric; MFGPN CRCW0805200RFKEAC
R23: 1K; R_0805_2012Metric; MFGPN CRCW08051K00FKEAC
R24: 49K9; R_0805_2012Metric; MFGPN CRCW080549K9DHEAP
RSHUNT1: 0.010; 1206_WIDE_SHUNT; MFGPN CFG0612-FX-R010ELF
TP7: TEST_POINT; PinHeader_1x02_P1.27mm_Vertical; MFGPN M50-3530242
TPSHUNT1: TestPoint_2Pole; PinHeader_1x02_P1.27mm_Vertical
U4: INA138; SOT-23-5; MFGPN INA138NA/3K
U5: OPA340NA; SOT-23-5; MFGPN OPA340NA/3K

Connections:
/CONTROLLER/I_SENSE: C45.1, R23.1; also elsewhere on the board
/FET/FET_OUT: D9.2 (A), Q1.3 (S); also elsewhere on the board
/FET/I_SENSE_N: RSHUNT1.3, TPSHUNT1.2, U4.4 (-)
/FET/I_SENSE_P: RSHUNT1.2, TPSHUNT1.1, U4.3 (+)
/FET_OUTPUT/FET_DRV_PD: R21.2; also elsewhere on the board
/FET_OUTPUT/FET_DRV_PU: R20.2; also elsewhere on the board
GND: C45.2, C49.2, D11.2 (A), R24.2, TP7.1, U4.2 (GND), U5.2 (V-); also elsewhere on the board
unnamed: C49.1, R26.2
unnamed: D9.1 (K), D10.2 (A), D11.1 (K), RSHUNT1.1
unnamed: Q1.1 (G), R20.1, R21.1, R26.1, TP7.2
unnamed: R23.2, U5.1, U5.4 (-)
unnamed: R24.1, U4.1, U5.3 (+)
_POWER_OUT: RSHUNT1.4; also elsewhere on the board
_VDD_3V3: U4.5 (V+), U5.5 (V+); also elsewhere on the board
_VDD_24V_PROT: D10.1 (K), Q1.2 (D); also elsewhere on the board

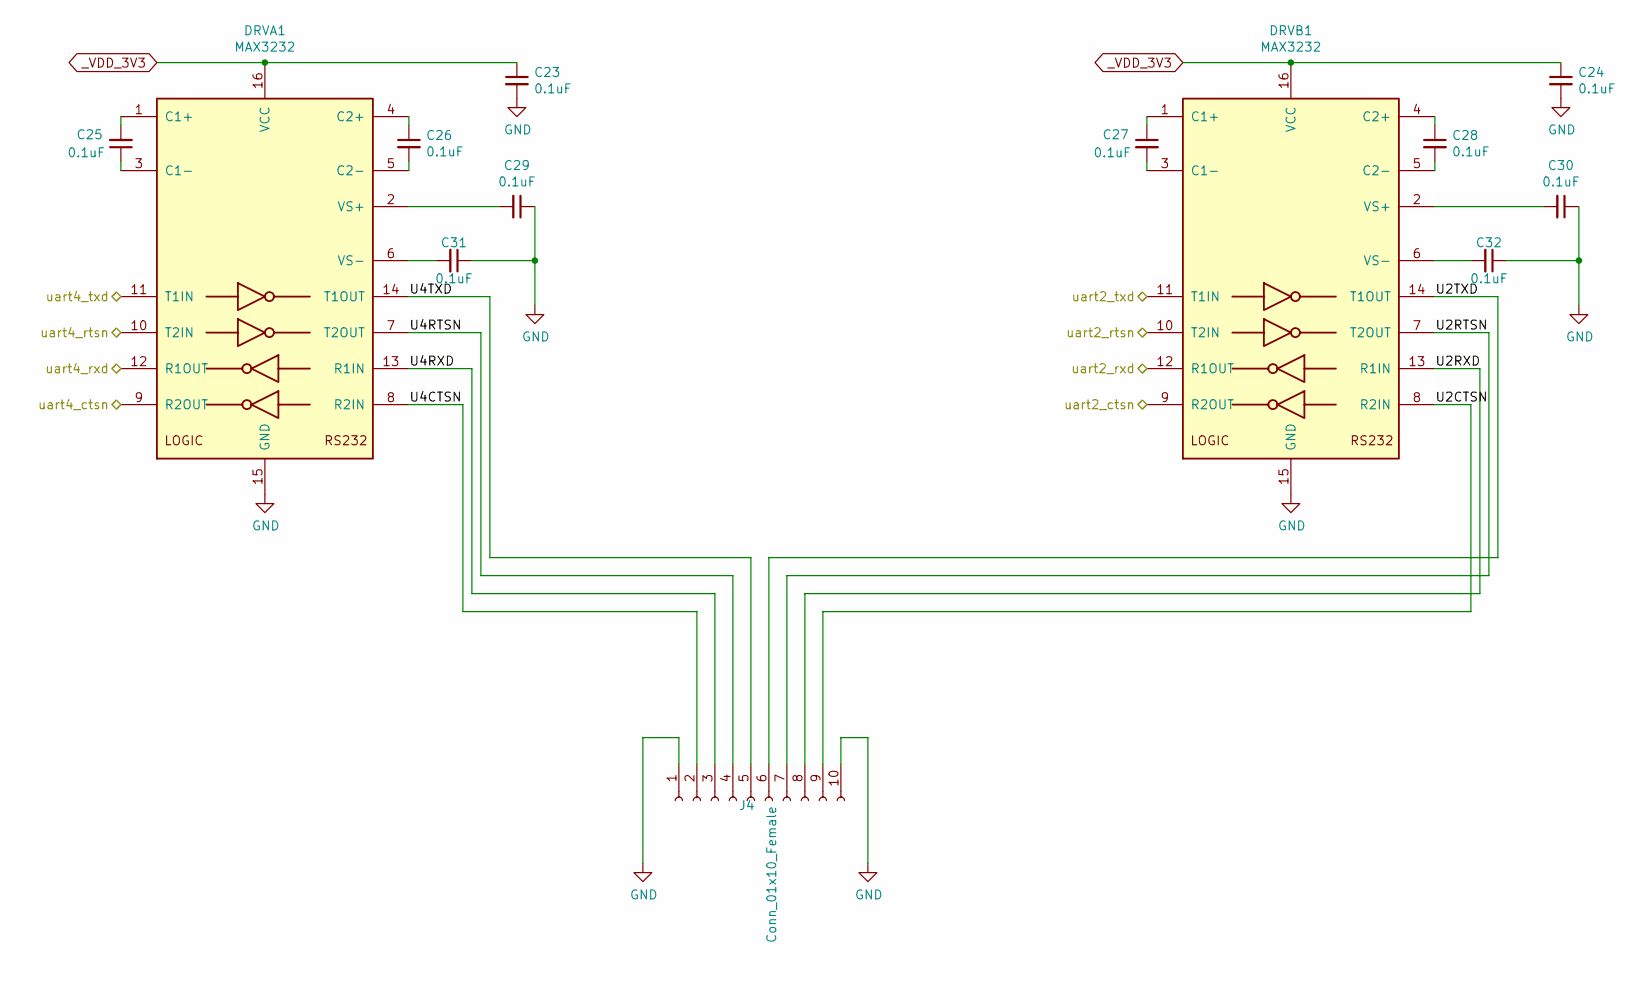
[picture p23: schematic RS232_TRANSCEIVERS.sch, VPSB]

Parts:
C23, C24, C25, C26, C27, C28, C29, C30, C31, C32: 0.1uF; C_0805_2012Metric; VOLTAGE 50; MFGPN CL21B104KBCNNNC
DRVA1: MAX3232; SOIC-16_3.9x9.9mm_P1.27mm; MFGPN MAX3232ECDR
DRVB1: MAX3232; SOIC-16_3.9x9.9mm_P1.27mm; MFGPN MAX3232ECDR
J4: Conn_01x10_Female; 10_POS_SPRING_TERM

Connections:
/BB_HEADERS/uart2_ctsn: DRVB1.9 (R2OUT); also elsewhere on the board
/BB_HEADERS/uart2_rtsn: DRVB1.10 (T2IN); also elsewhere on the board
/BB_HEADERS/uart2_rxd: DRVB1.12 (R1OUT); also elsewhere on the board
/BB_HEADERS/uart2_txd: DRVB1.11 (T1IN); also elsewhere on the board
/BB_HEADERS/uart4_ctsn: DRVA1.9 (R2OUT); also elsewhere on the board
/BB_HEADERS/uart4_rtsn: DRVA1.10 (T2IN); also elsewhere on the board
/BB_HEADERS/uart4_rxd: DRVA1.12 (R1OUT); also elsewhere on the board
/BB_HEADERS/uart4_txd: DRVA1.11 (T1IN); also elsewhere on the board
/RS232/U2CTSN: DRVB1.8 (R2IN), J4.9
/RS232/U2RTSN: DRVB1.7 (T2OUT), J4.7
/RS232/U2RXD: DRVB1.13 (R1IN), J4.8
/RS232/U2TXD: DRVB1.14 (T1OUT), J4.6
/RS232/U4CTSN: DRVA1.8 (R2IN), J4.2
/RS232/U4RTSN: DRVA1.7 (T2OUT), J4.4
/RS232/U4RXD: DRVA1.13 (R1IN), J4.3
/RS232/U4TXD: DRVA1.14 (T1OUT), J4.5
GND: C23.2, C24.2, C29.1, C30.1, C31.1, C32.1, DRVA1.15 (GND), DRVB1.15 (GND), J4.1, J4.10; also elsewhere on the board
unnamed: C25.1, DRVA1.3 (C1-)
unnamed: C25.2, DRVA1.1 (C1+)
unnamed: C26.1, DRVA1.4 (C2+)
unnamed: C26.2, DRVA1.5 (C2-)
unnamed: C27.1, DRVB1.1 (C1+)
unnamed: C27.2, DRVB1.3 (C1-)
unnamed: C28.1, DRVB1.4 (C2+)
unnamed: C28.2, DRVB1.5 (C2-)
unnamed: C29.2, DRVA1.2 (VS+)
unnamed: C30.2, DRVB1.2 (VS+)
unnamed: C31.2, DRVA1.6 (VS-)
unnamed: C32.2, DRVB1.6 (VS-)
_VDD_3V3: C23.1, C24.1, DRVA1.16 (VCC), DRVB1.16 (VCC); also elsewhere on the board

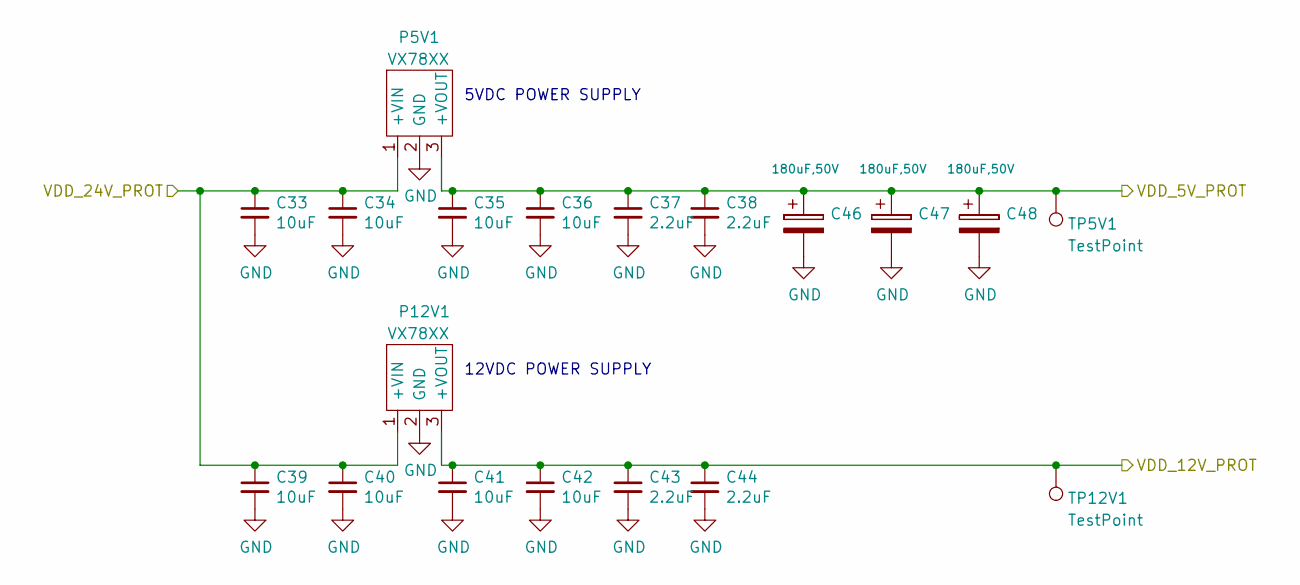
[picture p24: schematic POWER_SUPPLIES.sch, VPSB]

Parts:
C33, C34, C35, C36, C39, C40, C41, C42: 10uF; C_1206_3216Metric; VOLTAGE 50; MFGPN CL31B106KBHNNNE
C37, C38, C43, C44: 2.2uF; C_1206_3216Metric; VOLTAGE 50; MFGPN CL31A225KB9LNNC
C46, C47, C48: 180uF,50V; CP_Radial_D8.0mm_P3.50mm; MFGPN UPW1H181MPD
P5V1: VX78XX; Vx78-1000; MFGPN VX78012-1000
P12V1: VX78XX; Vx78-1000; MFGPN VX7805-1000
TP5V1, TP12V1: TestPoint; TestPoint_THTPad_D1.0mm_Drill0.5mm

Connections:
GND: C33.2, C34.2, C35.2, C36.2, C37.2, C38.2, C39.2, C40.2, C41.2, C42.2, C43.2, C44.2, C46.2, C47.2, C48.2, P5V1.2 (GND), P12V1.2 (GND); also elsewhere on the board
_VDD_5V_PROT: C35.1, C36.1, C37.1, C38.1, C46.1, C47.1, C48.1, P5V1.3 (+VOUT), TP5V1.1; also elsewhere on the board
_VDD_12V_PROT: C41.1, C42.1, C43.1, C44.1, P12V1.3 (+VOUT), TP12V1.1; also elsewhere on the board
_VDD_24V_PROT: C33.1, C34.1, C39.1, C40.1, P5V1.1 (+VIN), P12V1.1 (+VIN); also elsewhere on the board

Notes on the sheet:
5VDC POWER SUPPLY
12VDC POWER SUPPLY

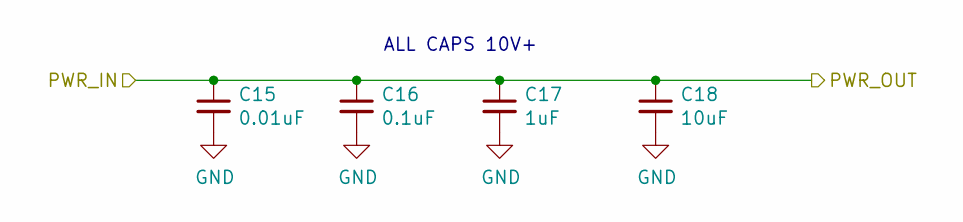
[picture p25: schematic FILTER_CAPS.sch, VPSB]

Parts:
C7: 0.01uF; C_0805_2012Metric; VOLTAGE 50; MFGPN CL21B103KBANNNC
C8: 0.1uF; C_0805_2012Metric; VOLTAGE 50; MFGPN CL21B104KBCNNNC
C9: 1uF; C_0805_2012Metric; VOLTAGE 50; MFGPN CL21B105KBFNFNE
C10: 10uF; C_0805_2012Metric; VOLTAGE 10; MFGPN CL21A106KPFNNNE

Connections:
GND: C7.2, C8.2, C9.2, C10.2; also elsewhere on the board
_VDD_3V3: C7.1, C8.1, C9.1, C10.1; also elsewhere on the board

Parts of its further copies:
C11, C15, C19: 0.01uF; C_0805_2012Metric; VOLTAGE 50; MFGPN CL21B103KBANNNC
C12, C16, C20: 0.1uF; C_0805_2012Metric; VOLTAGE 50; MFGPN CL21B104KBCNNNC
C13, C17, C21: 1uF; C_0805_2012Metric; VOLTAGE 50; MFGPN CL21B105KBFNFNE
C14, C18, C22: 10uF; C_0805_2012Metric; VOLTAGE 10; MFGPN CL21A106KPFNNNE

Connections of its further copies:
GND: C11.2, C12.2, C13.2, C14.2, C15.2, C16.2, C17.2, C18.2, C19.2, C20.2, C21.2, C22.2; also elsewhere on the board
_VDD_3V3: C11.1, C12.1, C13.1, C14.1, C15.1, C16.1, C17.1, C18.1, C19.1, C20.1, C21.1, C22.1; also elsewhere on the board

Notes on the sheet:
ALL CAPS 10V+

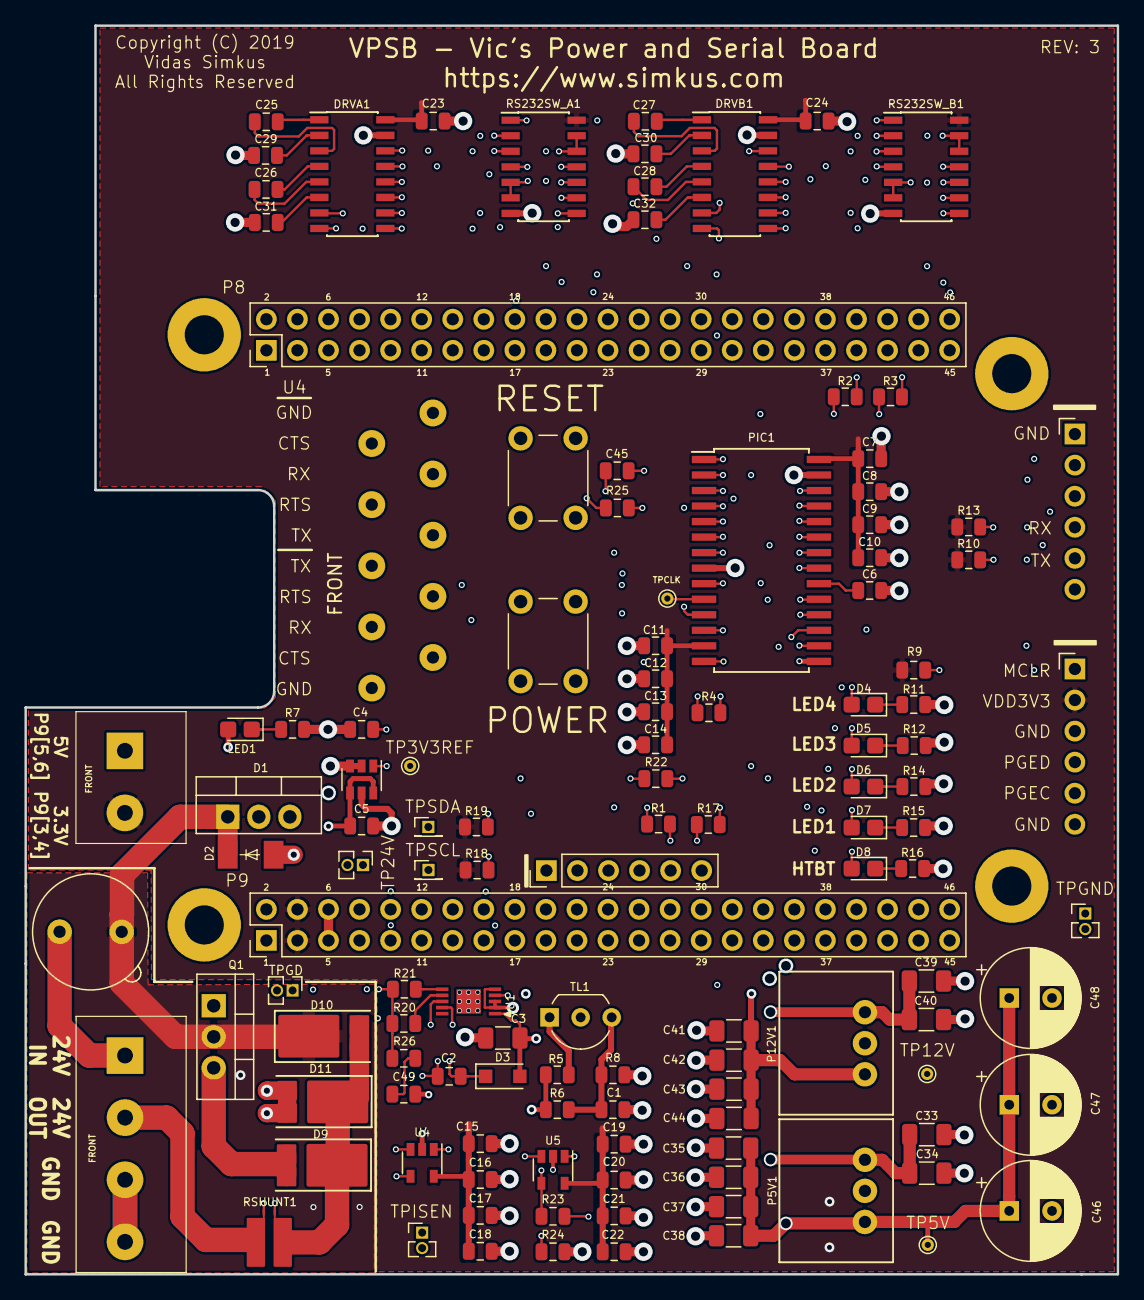
[picture p26: board BBB_SHIELD_V2.kicad_pcb from above]

Board: 4 copper layers, 89.3 x 102.1 mm, 121 parts (0 on the bottom side), 92 nets.

Other parts of the board:
C1: 0.1uF; C_0805_2012Metric
D1: 24V_TRIAC; TO-220-3_Vertical
D2: D_ALT; DO-214AA
F1: 24V_IN; Fuseholder_TR5_Littelfuse_No560_No460
LED1: LED; LED_0805_2012Metric_Castellated
R5: 1K; R_0805_2012Metric
R6: 49K9; R_0805_2012Metric
R7, R8: 4K7; R_0805_2012Metric
TL1: 24V_REF; TO-92_Inline_Wide_TI
TP2: TEST_POINT; PinHeader_1x02_P1.27mm_Vertical

Their connections:
/POWER_PROTECTION/VDD_24V: F1.1; also elsewhere on the board
/POWER_PROTECTION/VDD_24V_SHUNT: D1.3, R5.2, TL1.1
GND: C1.2, D1.2, D2.2, R7.2, R8.2, TL1.2, TP2.1; also elsewhere on the board
unnamed: C1.1, R6.2, R8.1, TL1.3
unnamed: LED1.1, R7.1
_VDD_24V_PROT: D1.1, D2.1, F1.2, LED1.2, R5.1, R6.1, TP2.2; also elsewhere on the board
