vic-simkus/VIOBOARD_V1_Schematics/BBB_SHIELD/BBB_SHIELD.kicad_pcb

## KiCad design BBB_SHIELD/BBB_SHIELD.kicad_pcb (2018-09-03, an earlier design)

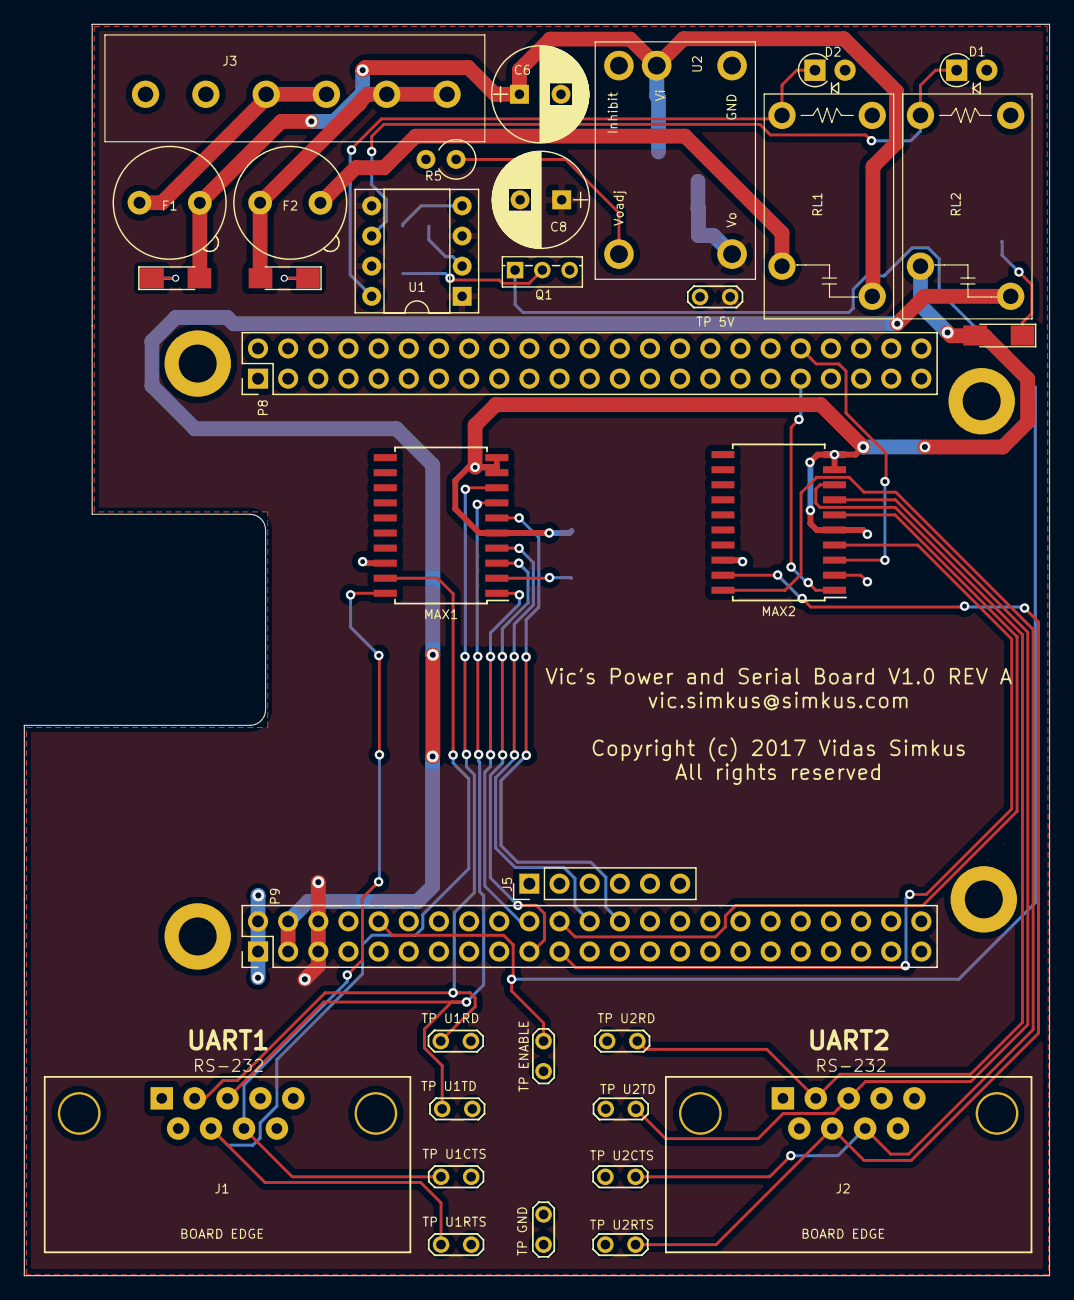
[picture p27: board BBB_SHIELD.kicad_pcb from above]

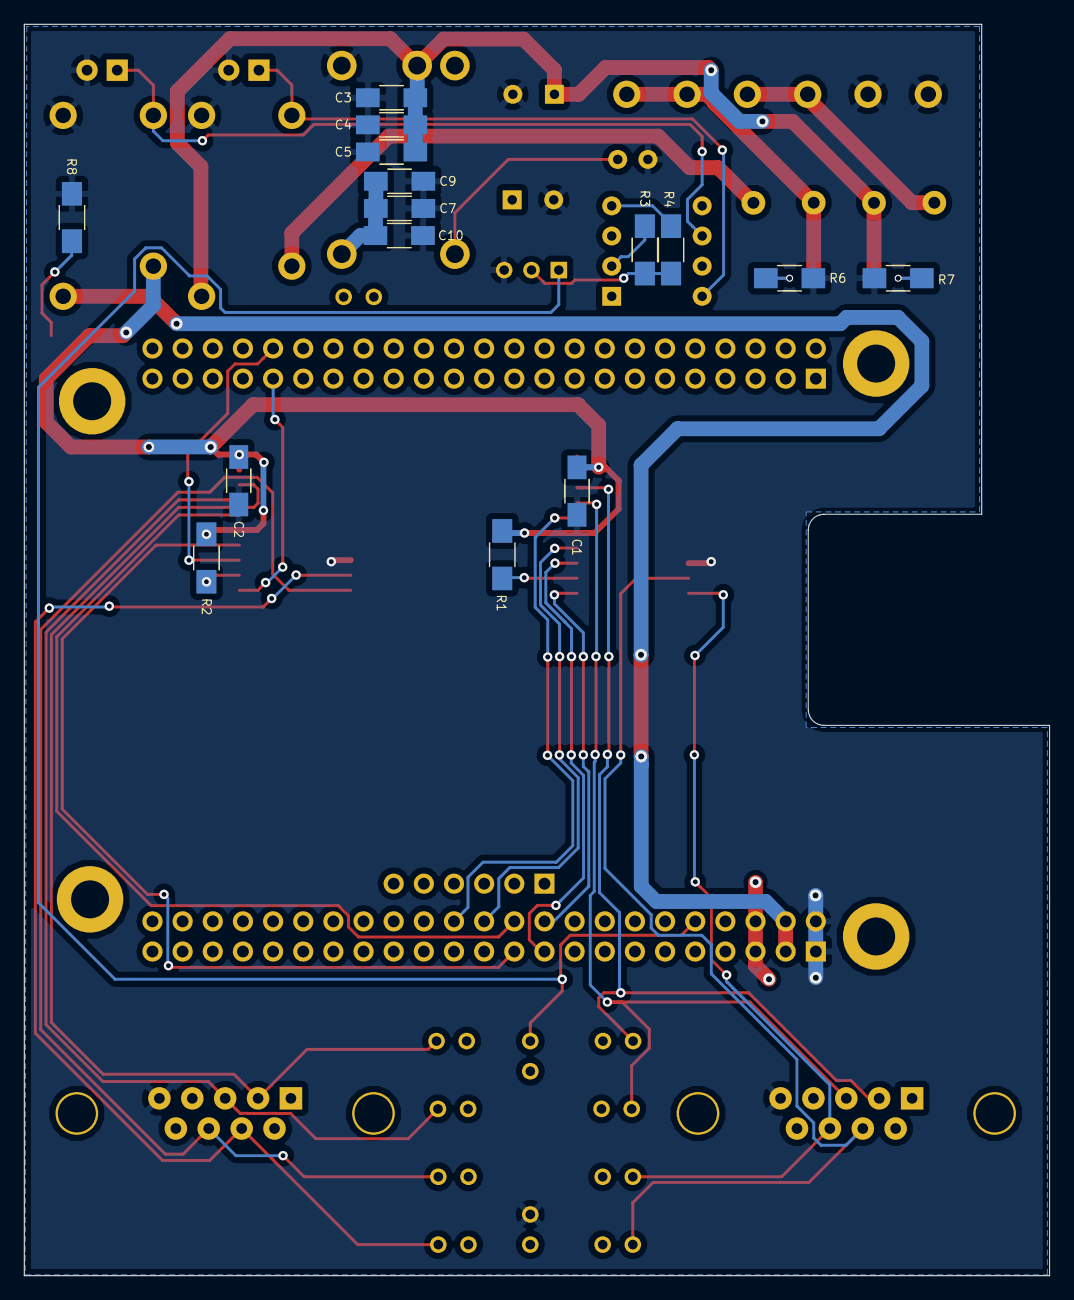
[picture p28: board BBB_SHIELD.kicad_pcb from below]

Board: 2 copper layers, 86.4 x 105.4 mm, 49 parts (15 on the bottom side), 36 nets.

Parts:
C1, C2: .1uF; C_1206_HandSoldering
C3, C10: 2.2uF; C_1206_HandSoldering
C4, C9: 1uF; C_1206_HandSoldering
C5, C7: 10uF; C_1206_HandSoldering
C6, C8: 180uF; CP_Radial_D8.0mm_P3.50mm
D1, D2: D; D_A-405_P2.54mm_Vertical_AnodeUp
F1, F2: Fuse; Fuseholder_Fuse_TR5_Littlefuse-No560_No460
J1: UART1; D_SUB_9_RIGHT
J2: UART2; D_SUB_9_RIGHT
J3: PWR_CONN; OSTTA064163
J4: TEST_1P; Test_Point_2Pads
J5: Screw_Terminal_1x06; Pin_Header_Straight_1x06_Pitch2.54mm
J6: TP_U1_CTS; Test_Point_2Pads
J7: TP_U1_RD; Test_Point_2Pads
J8: TP_U2_CTS; Test_Point_2Pads
J9: TP_U2_RD; Test_Point_2Pads
J10: TP_EN; Test_Point_2Pads
J11: TP_U1_TD; Test_Point_2Pads
J12: TP_U1_RTS; Test_Point_2Pads
J13: TP_U2_TD; Test_Point_2Pads
J14: TP_U2_RTS; Test_Point_2Pads
J15: TP_GND; Test_Point_2Pads
LED1: 24V_SW; LED_1206_HandSoldering
LED2: 24V_PROT; LED_1206_HandSoldering
LED3: 33V_SW; LED_1206_HandSoldering
MAX1, MAX2: MAX3233E; SOIC-20W_7.5x12.8mm_Pitch1.27mm
P8: P8; Pin_Header_Straight_2x23_Pitch2.54mm
P9: P9; Pin_Header_Straight_2x23_Pitch2.54mm
Q1: F3055L; TO-251_IPAK_Vertical
R1, R2: 10K; R_1206_HandSoldering
R3, R4, R8: 470; R_1206_HandSoldering
R5: 21K; R_Axial_DIN0309_L9.0mm_D3.2mm_P2.54mm_Vertical
R6, R7: 4.7K; R_1206_HandSoldering
RL1: 24V RELAY; OJ-SH-105LMH000-ND
RL2: 3.3V RELAY; OJ-SH-105LMH000-ND
U1: TLP222A-2-C; DIP-8_W7.62mm_Socket
U2: PTN78000WAH; PTN78000H

Connections:
/POWER_CONTROL/ENABLE: J10.1, P9.10, Q1.1
/POWER_CONTROL/VDD_24V_IN: F1.1, J3.3, J3.4
/POWER_CONTROL/VDD_24V_SW_OUT: F2.1, J3.5, J3.6, LED1.2
/SERIAL_IO/DB9_U1_CTS: J1.8, J6.1, MAX1.20
/SERIAL_IO/DB9_U1_RD(RX): J1.2, J7.1, MAX1.8
/SERIAL_IO/DB9_U1_RTS: J1.7, J12.1, MAX1.19
/SERIAL_IO/DB9_U1_TD(TX): J1.3, J11.1, MAX1.7
/SERIAL_IO/DB9_U2_CTS: J2.8, J8.1, MAX2.20
/SERIAL_IO/DB9_U2_RD(RX): J2.2, J9.1, MAX2.8
/SERIAL_IO/DB9_U2_RTS: J2.7, J14.1, MAX2.19
/SERIAL_IO/DB9_U2_TD(TX): J2.3, J13.1, MAX2.7
/U1_CTS: MAX1.1, P9.20
/U1_RTS: MAX1.3, P9.19
/U1_RX: MAX1.6, P9.26
/U1_TX: MAX1.4, P9.24
/U2_CTS: MAX2.1, P8.37
/U2_RTS: MAX2.3, P8.38
/U2_RX: MAX2.6, P9.22
/U2_TX: MAX2.4, P9.21
GND: C1.2, C2.2, C3.2, C4.2, C5.2, C6.2, C7.2, C8.2, C9.2, C10.2, D1.2, D2.2, J1.5, J2.5, J3.1, J3.2, J15.1, MAX1.18, MAX2.18, P9.1, P9.2, Q1.3, R5.2, R6.2, R7.2, R8.2, RL1.2, RL2.2, U2.1
unnamed: D1.1, RL2.1, U1.6
unnamed: D2.1, RL1.1, U1.8
unnamed: LED1.1, R6.1
unnamed: LED2.1, R7.1
unnamed: LED3.1, R8.1
unnamed: MAX1.2, R1.2
unnamed: MAX2.2, R2.2
unnamed: Q1.2, R3.2, R4.2
unnamed: R3.1, U1.2
unnamed: R4.1, U1.4
unnamed: R5.1, U2.4
VDD_5V_PROT: C7.1, C8.1, C9.1, C10.1, J4.1, P9.5, P9.6, U1.1, U1.3, U1.5, U1.7, U2.5
VDD_24V_PROT: C3.1, C4.1, C5.1, C6.1, F1.2, LED2.2, RL1.4, U2.2
VDD_24V_SW: F2.2, RL1.3
VDD_33V: P9.3, P9.4, RL2.4
VDD_33V_SW: C1.1, C2.1, LED3.2, MAX1.5, MAX1.9, MAX1.10, MAX2.5, MAX2.9, MAX2.10, R1.1, R2.1, RL2.3
