vic-simkus/VIOBOARD_V1_Schematics/VIOBOARD/VIOBOARD.kicad_pcb

## KiCad design VIOBOARD/VIOBOARD.kicad_pcb (2018-09-03)

Schematic: VIOBOARD.sch, Vic's IO BOARD V1.0

Parts:
J1: Screw_Terminal_1x04; OSTTA044163; MFGPN OSTTA044163
J2: Conn_02x02_Top_Bottom; Pin_Header_Straight_2x02_Pitch1.27mm
J8, J9: TEST_1P; Test_Point_2Pads
SW1: BOARD_RESET; SW_PUSH_6mm; MFGPN 1825910-6

Connections:
/IOCONTROLLER/IO_RESET: J2.1; also elsewhere on the board
/comm_controller/COMM_RESET: J2.3; also elsewhere on the board
/power_protection/VDD_24V: J1.1, J1.2; also elsewhere on the board
unnamed: J2.2, J2.4
RESET: SW1.2
VDD_24V_PROT: J9.1; also elsewhere on the board

Notes on the sheet:
INCOMMING POWER

Schematic: power_protection.sch, Vic's IO BOARD V1.0

Parts:
C1: 0.012uF 50V; C_1206; MFGPN 12065C123KAT2A
C2: 0.1uF 50V; C_1206; MFGPN GCM319R71H104KA37D
C3: 1uF 50V; C_1206
C4: 10uF 50V; C_1206
C5: 1nF 50V; C_1206; MFGPN GRM319R71H102KA01D
D1: 24V_TRIAC; TO-220_Vertical; MFGPN ACTT6X-800E,127
D2: D_ALT; DO-214AA; MFGPN SMBJ26A
F1: 24V_IN; Fuseholder_Fuse_TR5_Littlefuse-No560_No460; MFGPN 56000001319
LED11: Vf=2V; LED_0805; MFGPN LS R976-NR-1
R2: 23.2K 1%; R_0805; MFGPN CRCW080523K2FKEA
R3: 2.49K 1%; R_0805; MFGPN RC0805FR-072K49L
R4: 910 1%; R_0805; MFGPN CRCW0805910RFKEA
R5: 4.7K 1%; R_0805; MFGPN CRCW08054K70FKEA
R65: 100 1%; R_2512; MFGPN CRM2512-FX-1000ELF
TL1: 24V_REF; TO-92_Inline_Wide; MFGPN TL431BCLPR

Connections:
/power_protection/VDD_24V: R65.2; also elsewhere on the board
/power_protection/VDD_24V_SHUNT: D1.3, R4.2, TL1.1
unnamed: C1.1, C2.1, C3.1, C4.1, F1.1, R65.1
unnamed: C5.1, R2.2, R3.1, TL1.3
unnamed: LED11.1, R5.1
VDD_24V_PROT: D1.1, D2.1, F1.2, LED11.2, R2.1, R4.1; also elsewhere on the board

Notes on the sheet:
Vgt = 1V
Vref=2.507V
Vout = 2.520 @ Vin = 26 I = 1mA @ 26V
24V PROT
TL431
ACTT6X-800E

Schematic: comm_controller.sch, Vic's IO BOARD V1.0

Parts:
C6: 18pF 50V; C_0805; MFGPN CL21C180JBANNNC
C7: 20pF 50V; C_0805; MFGPN C0805C200K5GACTU
C8: 10uF 50V; C_1206
J3: BOARD_COMM; D_SUB_9_RIGHT; MFGPN 3-1634580-2
J12: TP SCL; Test_Point_2Pads
J13: TP SDA; Test_Point_2Pads
J14: TP_CTS; Test_Point_2Pads
J15: TP_TD; Test_Point_2Pads
J16: TP_RTS; Test_Point_2Pads
J17: TP_RD; Test_Point_2Pads
J18: TP_GND; Test_Point_2Pads
J19: CONN_01X06; Pin_Header_Angled_1x06_Pitch2.54mm; MFGPN 0022052061
LED14: Vf=2V; LED_0805; MFGPN LY R976-PS-36
PIC1: PIC24FVXXKA302; PIC_SOIC-28; MFGPN PIC24FV32KA302-I/SO
R6, R7: 4.7K 1%; R_0805; MFGPN CRCW08054K70FKEA
R8: 10K 1%; R_0805; MFGPN CRCW080510K0FKTA
R9: 470 1%; R_0805; MFGPN CRCW0805470RFKEA
Y1: 8MHz; Crystal_HC49-4H_Vertical; MFGPN 9B-8.000MEEJ-B

Connections:
/I2C_SCL: J12.1, PIC1.15, R6.2; also elsewhere on the board
/I2C_SDA: J13.1, PIC1.14, R7.2; also elsewhere on the board
/comm_controller/COMM_RESET: J19.1, PIC1.1, R8.1; also elsewhere on the board
/comm_controller/CTS: J3.8, J14.1; also elsewhere on the board
/comm_controller/RD(RX): J3.2, J17.1; also elsewhere on the board
/comm_controller/RTS: J3.7, J16.1; also elsewhere on the board
/comm_controller/TD(TX): J3.3, J15.1; also elsewhere on the board
/comm_controller/U1CTS: PIC1.17; also elsewhere on the board
/comm_controller/U1RTS: PIC1.18; also elsewhere on the board
/comm_controller/U1RX: PIC1.6; also elsewhere on the board
/comm_controller/U1TX: PIC1.16; also elsewhere on the board
unnamed: C6.1, PIC1.9, Y1.1
unnamed: C7.1, PIC1.10, Y1.2
unnamed: C8.2, PIC1.20
unnamed: J19.4, PIC1.4
unnamed: J19.5, PIC1.5
unnamed: LED14.1, R9.2
unnamed: LED14.2, PIC1.25
VDD_5V_PROT: J19.2, PIC1.13, PIC1.28, R6.1, R7.1, R8.2; also elsewhere on the board

Notes on the sheet:
RB0 - ICSP - PGED
RB1 - ICSP - PGEC
RB2 - U1RX - RS1_OUT
RB5 - ASDA
RB6 - ASCL
RB7 - U1TX - TTL1_IN
RB8 - U1CTS - RS2_OUT
RB9 - U1RTS - TTL2_IN
RB14 - GPIO
SDA
SCL
BOM - 2017-06-09
COMMHTBT

Schematic: IOCONTROLLER.sch, Vic's IO BOARD V1.0

Parts:
C18: 20pF 50V; C_0805; MFGPN C0805C200K5GACTU
C19: 18pF 50V; C_0805; MFGPN CL21C180JBANNNC
J20: CONN_01X06; Pin_Header_Angled_1x06_Pitch2.54mm; MFGPN 0022052061
R10: 10K 1%; R_0805; MFGPN CRCW080510K0FKTA
Y2: 10MHz; Crystal_HC49-4H_Vertical; MFGPN 9B-10.000MEEJ-B
dsPIC1: dsPIC30F4013; TQFP-44_10x10mm_Pitch0.8mm; MFGPN DSPIC30F4013-30I/PT

Connections:
/I2C_SCL: dsPIC1.44; also elsewhere on the board
/I2C_SDA: dsPIC1.1; also elsewhere on the board
/IOCONTROLLER/AI_ENABLE/RC13: dsPIC1.32; also elsewhere on the board
/IOCONTROLLER/AI_FAULT/R0: dsPIC1.9; also elsewhere on the board
/IOCONTROLLER/AI_PROT/PP_AI_FAULT_LED: dsPIC1.36; also elsewhere on the board
/IOCONTROLLER/AN3/RB3/420_4: dsPIC1.22; also elsewhere on the board
/IOCONTROLLER/AN4/RB4/420_3: dsPIC1.23; also elsewhere on the board
/IOCONTROLLER/AN5/RB5/420_2: dsPIC1.24; also elsewhere on the board
/IOCONTROLLER/AN8/RB8/420_1: dsPIC1.27; also elsewhere on the board
/IOCONTROLLER/AUX_LED: dsPIC1.35; also elsewhere on the board
/IOCONTROLLER/BUS_IN_LED: dsPIC1.37; also elsewhere on the board
/IOCONTROLLER/BUS_OUT_LED: dsPIC1.41; also elsewhere on the board
/IOCONTROLLER/DIGITAL_OUT/PP_DO_FAULT_LED: dsPIC1.38; also elsewhere on the board
/IOCONTROLLER/DO1/RF1: dsPIC1.4; also elsewhere on the board
/IOCONTROLLER/DO2/RF0: dsPIC1.5; also elsewhere on the board
/IOCONTROLLER/DO3/RF6: dsPIC1.43; also elsewhere on the board
/IOCONTROLLER/DO4/RF4: dsPIC1.3; also elsewhere on the board
/IOCONTROLLER/DO_ENABLE/RF5: dsPIC1.2; also elsewhere on the board
/IOCONTROLLER/DO_FAULT/RD1: dsPIC1.8; also elsewhere on the board
/IOCONTROLLER/DSPIC_PGC: J20.5, dsPIC1.25
/IOCONTROLLER/DSPIC_PGD: J20.4, dsPIC1.26
/IOCONTROLLER/HTBT_LED: dsPIC1.42; also elsewhere on the board
/IOCONTROLLER/IO_RESET: J20.1, R10.1, dsPIC1.18; also elsewhere on the board
/IOCONTROLLER/RB1/AN1/ICD3: dsPIC1.20; also elsewhere on the board
/IOCONTROLLER/RB2/AN2/ICD4: dsPIC1.21; also elsewhere on the board
/IOCONTROLLER/RB9/AN9/ICD1: dsPIC1.15; also elsewhere on the board
/IOCONTROLLER/RB10/AN10/ICD2: dsPIC1.14; also elsewhere on the board
/IOCONTROLLER/VREF+/VREF+: dsPIC1.19; also elsewhere on the board
unnamed: C18.2, Y2.1, dsPIC1.31
unnamed: C19.2, Y2.2, dsPIC1.30
VDD_5V_PROT: J20.2, R10.2, dsPIC1.7, dsPIC1.17, dsPIC1.28, dsPIC1.40; also elsewhere on the board

Notes on the sheet:
BOM - 2017-06-09

Schematic: 5V_POWER_SUPPLY.sch, Vic's IO BOARD V1.0

Parts:
C44: 2.2uF 50V; C_1206; MFGPN GCM31CR71H225KA55L
C45: 1uF 50V; C_1206; MFGPN GRM31CR71H105KA61L
C46, C48: 10uF 50V; C_1206; MFGPN CL31B106KBHNNNE
C47, C49: 180uF; CP_Radial_D8.0mm_P3.50mm; MFGPN EEU-FC1H181L
C50: 1uF 50V; C_0805; MFGPN CL21B105KBFNNNF
C51: 2.2uF 50V; C_0805; MFGPN C2012X7R1H225K125AC
J11: TEST_1P; Test_Point_2Pads
R45: 21K 1%; R_0805; MFGPN CRCW080521K0FKEA
R66, R67, R68, R69: 0 1%; R_0805; MFGPN CRCW08050000Z0EBC
U9: PTN78000WAH; PTN78000H; MFGPN PTN78000WAH

Connections:
unnamed: C44.1, R66.2
unnamed: C45.1, R67.2
unnamed: C46.1, R68.2
unnamed: C47.1, R69.2
unnamed: R45.1, U9.4
VDD_5V_PROT: C48.1, C49.1, C50.1, C51.1, J11.1, U9.5; also elsewhere on the board
VDD_24V_PROT: R66.1, R67.1, R68.1, R69.1, U9.2; also elsewhere on the board

Schematic: COMM_PWR_DEC.sch, Vic's IO BOARD V1.0

Parts:
C10: 0.01uF 50V; C_0805; MFGPN CL21B103KBANNNC
C11: 0.1uF 50V; C_0805; MFGPN CL21B104KBCNNNC
C12: 1uF 50V; C_0805; MFGPN CL21B105KBFNNNF
C13: 10uF 50V; C_1206

Connections:
VDD_5V_PROT: C10.1, C11.1, C12.1, C13.1; also elsewhere on the board

Parts of its further copies:
C14: 0.01uF 50V; C_0805; MFGPN CL21B103KBANNNC
C15: 0.1uF 50V; C_0805; MFGPN CL21B104KBCNNNC
C16: 1uF 50V; C_0805; MFGPN CL21B105KBFNNNF
C17: 10uF 50V; C_1206

Connections of its further copies:
VDD_5V_PROT: C14.1, C15.1, C16.1, C17.1; also elsewhere on the board

Schematic: MAX232.sch, Vic's IO BOARD V1.0

Parts:
C60, C61, C62, C63, C64: 1uF 50V; C_0805; MFGPN CL21B105KBFNNNF
U1: MAX232I; SOIC-16_3.9x9.9mm_Pitch1.27mm; MFGPN MAX232ID

Connections:
/comm_controller/CTS: U1.8 (R2IN); also elsewhere on the board
/comm_controller/RD(RX): U1.13 (R1IN); also elsewhere on the board
/comm_controller/RTS: U1.7 (T2OUT); also elsewhere on the board
/comm_controller/TD(TX): U1.14 (T1OUT); also elsewhere on the board
/comm_controller/U1CTS: U1.9 (R2OUT); also elsewhere on the board
/comm_controller/U1RTS: U1.10 (T2IN); also elsewhere on the board
/comm_controller/U1RX: U1.12 (R1OUT); also elsewhere on the board
/comm_controller/U1TX: U1.11 (T1IN); also elsewhere on the board
unnamed: C60.1, U1.1 (C1+)
unnamed: C60.2, U1.3 (C1-)
unnamed: C61.1, U1.4 (C2+)
unnamed: C61.2, U1.5 (C2-)
unnamed: C62.1, U1.2 (VS+)
unnamed: C63.1, U1.6 (VS-)
VDD_5V_PROT: C64.1, U1.16 (VCC); also elsewhere on the board

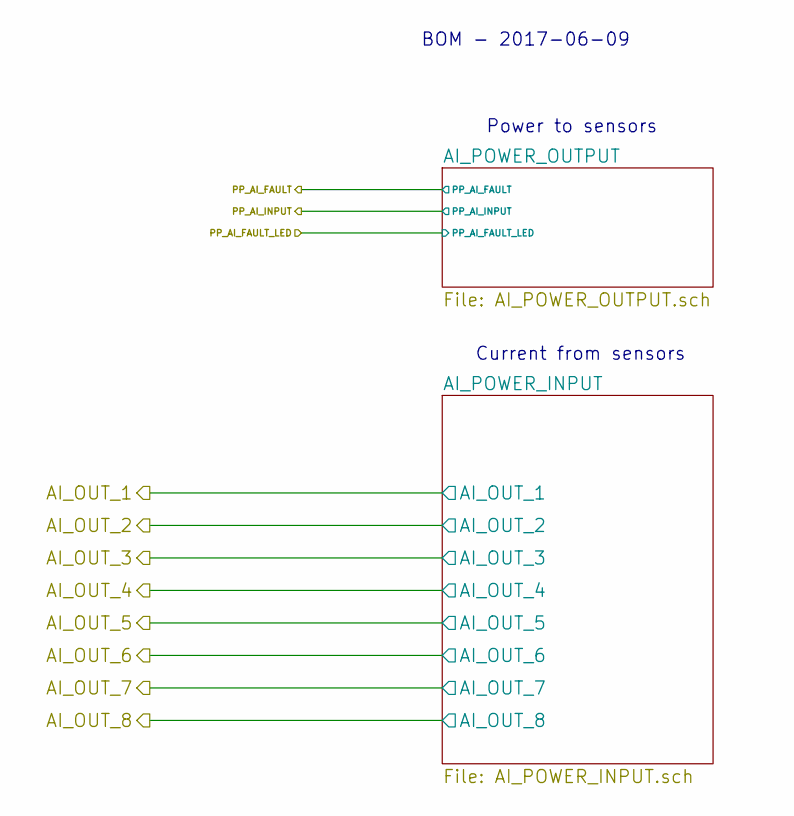
[picture p29: schematic AI_PROT.sch, Vic's IO BOARD V1.0]

Notes on the sheet:
Power to sensors
Current from sensors
BOM - 2017-06-09

Schematic: AI_INPUT.sch, Vic's IO BOARD V1.0

Parts:
C21: 0.01uF 50V; C_0805; MFGPN CL21B103KBANNNC
C22: 0.1uF 50V; C_0805; MFGPN CL21B104KBCNNNC
C23, C52, C53, C54, C55, C56, C57, C58, C59: 1uF 50V; C_0805; MFGPN CL21B105KBFNNNF
C24: 10uF 50V; C_1206
R20, R22, R24, R28: 910 1%; R_0805; MFGPN RC2012F822CS
R21, R23, R26, R30: 8.2K 1%; R_0805; MFGPN CRCW0805910RFKEA
R25, R27, R29, R31: 250 0.1%; R_Axial_DIN0309_L9.0mm_D3.2mm_P2.54mm_Vertical; MFGPN CMF55250R00BHEK
R32, R33, R34, R35: 1K 0.1%; R_0805; MFGPN ERJ-PB6B1001V
R78, R79, R80, R81, R82, R83, R84, R85: 1K 1%; R_0805; MFGPN CRCW08051K00FKEA
U5: MCP6004_C; SOIC-14_3.9x8.7mm_Pitch1.27mm; MFGPN MCP6004T-I/SL

Connections:
/IOCONTROLLER/AI_INPUT/AI_IN_420_1: R31.2, R80.1; also elsewhere on the board
/IOCONTROLLER/AI_INPUT/AI_IN_420_2: R29.2, R82.1; also elsewhere on the board
/IOCONTROLLER/AI_INPUT/AI_IN_420_3: R27.2, R84.1; also elsewhere on the board
/IOCONTROLLER/AI_INPUT/AI_IN_420_4: R25.2, R85.1; also elsewhere on the board
/IOCONTROLLER/AI_INPUT/AI_IN_ICD_1: R35.2, U5.3; also elsewhere on the board
/IOCONTROLLER/AI_INPUT/AI_IN_ICD_2: R34.2, U5.5; also elsewhere on the board
/IOCONTROLLER/AI_INPUT/AI_IN_ICD_3: R33.2, U5.10; also elsewhere on the board
/IOCONTROLLER/AI_INPUT/AI_IN_ICD_4: R32.2, U5.12; also elsewhere on the board
/IOCONTROLLER/AI_INPUT/Vina-: R28.2, R30.2, U5.2
/IOCONTROLLER/AI_INPUT/Vinb-: R24.2, R26.2, U5.6
/IOCONTROLLER/AI_INPUT/Vinc-: R22.2, R23.2, U5.9
/IOCONTROLLER/AI_INPUT/Vind-: R20.2, R21.2, U5.13
/IOCONTROLLER/AI_INPUT/Vouta: R30.1, R83.1, U5.1
/IOCONTROLLER/AI_INPUT/Voutb: R26.1, R81.1, U5.7
/IOCONTROLLER/AI_INPUT/Voutc: R23.1, R79.1, U5.8
/IOCONTROLLER/AI_INPUT/Voutd: R21.1, R78.1, U5.14
/IOCONTROLLER/AN3/RB3/420_4: C58.2, R85.2; also elsewhere on the board
/IOCONTROLLER/AN4/RB4/420_3: C56.2, R84.2; also elsewhere on the board
/IOCONTROLLER/AN5/RB5/420_2: C54.2, R82.2; also elsewhere on the board
/IOCONTROLLER/AN8/RB8/420_1: C52.2, R80.2; also elsewhere on the board
/IOCONTROLLER/RB1/AN1/ICD3: C55.1, R79.2; also elsewhere on the board
/IOCONTROLLER/RB2/AN2/ICD4: C53.1, R78.2; also elsewhere on the board
/IOCONTROLLER/RB9/AN9/ICD1: C59.1, R83.2; also elsewhere on the board
/IOCONTROLLER/RB10/AN10/ICD2: C57.1, R81.2; also elsewhere on the board
VDD_5V_PROT: C21.2, C22.1, C23.1, C24.1, U5.4; also elsewhere on the board

Schematic: STATUS_LEDS.sch, Vic's IO BOARD V1.0

Parts:
LED2: Vf=2V; LED_0805; MFGPN LY R976-PS-36
LED3, LED4, LED5: Vf=2V; LED_0805; MFGPN LS R976-NR-1
R1, R46, R47, R48: 470 1%; R_0805; MFGPN CRCW0805470RFKEA

Connections:
/IOCONTROLLER/AUX_LED: LED5.2; also elsewhere on the board
/IOCONTROLLER/BUS_IN_LED: LED3.2; also elsewhere on the board
/IOCONTROLLER/BUS_OUT_LED: LED4.2; also elsewhere on the board
/IOCONTROLLER/HTBT_LED: LED2.2; also elsewhere on the board
unnamed: LED2.1, R1.2
unnamed: LED3.1, R46.2
unnamed: LED4.1, R47.2
unnamed: LED5.1, R48.2

Notes on the sheet:
BOM - 2017-06-09
HTBT LED is yellow

Schematic: DIGITAL_OUT.sch, Vic's IO BOARD V1.0

Parts:
D20, D21, D22, D23: D_ALT; D_SOD-323_CUSTOM; MFGPN CUS08F30,H3F
J7: Screw_Terminal_1x04; OSTTA044163; MFGPN OSTTA044163
LED6, LED7, LED8, LED9: Vf=2V; LED_0805; MFGPN LS R976-NR-1
R49, R50, R51, R52: 470 1%; R_0805; MFGPN CRCW0805470RFKEA
R61, R62, R63, R64: 100 1%; R_0805; MFGPN ERJ-P06F1000V
R86, R87, R88, R89: 4.7K 1%; R_0805; MFGPN CRCW08054K70FKEA
TLPA1: TLP222A-2-C; DIP-8_W7.62mm_Socket; MFGPN TLP222A-2(F)
TLPB1: TLP222A-2-C; DIP-8_W7.62mm_Socket; MFGPN TLP222A-2(F)

Connections:
/IOCONTROLLER/DIGITAL_OUT/DO_POWER_OUT: TLPA1.5, TLPA1.7, TLPB1.5, TLPB1.7; also elsewhere on the board
/IOCONTROLLER/DO1/RF1: TLPA1.3; also elsewhere on the board
/IOCONTROLLER/DO2/RF0: TLPA1.1; also elsewhere on the board
/IOCONTROLLER/DO3/RF6: TLPB1.1; also elsewhere on the board
/IOCONTROLLER/DO4/RF4: TLPB1.3; also elsewhere on the board
unnamed: D20.1, R61.2
unnamed: D20.2, LED6.2, TLPA1.6
unnamed: D21.1, R62.2
unnamed: D21.2, LED7.2, TLPA1.8
unnamed: D22.1, R63.2
unnamed: D22.2, LED8.2, TLPB1.6
unnamed: D23.1, R64.2
unnamed: D23.2, LED9.2, TLPB1.8
unnamed: J7.1, R61.1
unnamed: J7.2, R62.1
unnamed: J7.3, R63.1
unnamed: J7.4, R64.1
unnamed: LED6.1, R86.1
unnamed: LED7.1, R87.1
unnamed: LED8.1, R88.1
unnamed: LED9.1, R89.1
unnamed: R49.1, TLPB1.2
unnamed: R50.1, TLPB1.4
unnamed: R51.1, TLPA1.2
unnamed: R52.1, TLPA1.4

Notes on the sheet:
DOUT
DOUT2
DOUT3
DOUT4

Schematic: PWR_DEC.sch, Vic's IO BOARD V1.0

Parts:
C26: 0.01uF 50V; C_0805; MFGPN CL21B103KBANNNC
C27: 0.1uF 50V; C_0805; MFGPN CL21B104KBCNNNC
C28: 1uF 50V; C_0805; MFGPN CL21B105KBFNNNF
C29: 10uF 50V; C_1206

Connections:
VDD_5V_PROT: C26.1, C27.1, C28.1, C29.1; also elsewhere on the board

Parts of its further copies:
C30, C34, C38: 0.01uF 50V; C_0805; MFGPN CL21B103KBANNNC
C31, C35, C39: 0.1uF 50V; C_0805; MFGPN CL21B104KBCNNNC
C32, C36, C40: 1uF 50V; C_0805; MFGPN CL21B105KBFNNNF
C33, C37, C41: 10uF 50V; C_1206

Connections of its further copies:
VDD_5V_PROT: C30.1, C31.1, C32.1, C33.1, C34.1, C35.1, C36.1, C37.1, C38.1, C39.1, C40.1, C41.1; also elsewhere on the board

Schematic: VREF+.sch, Vic's IO BOARD V1.0

Parts:
C42: 0.1uF 50V; C_1206
C43: 0.1uF 50V; C_0805; MFGPN CL21B104KBCNNNC
J10: TEST_1P; Test_Point_2Pads
U7: REF02CSZ; SOIC-8_3.9x4.9mm_Pitch1.27mm; MFGPN REF02CSZ

Connections:
/IOCONTROLLER/VREF+/VREF+: C43.1, J10.1, U7.6; also elsewhere on the board
VDD_24V_PROT: C42.1, U7.2; also elsewhere on the board

Schematic: AI_POWER_OUTPUT.sch, Vic's IO BOARD V1.0

Parts:
D24, D25, D26, D27, D28, D29, D30, D31: D_ALT; D_SOD-323_CUSTOM; MFGPN CUS08F30,H3F
J5: 24V OUTPUT; OSTTA084163; MFGPN OSTTA084163
R70, R71, R72, R73, R74, R75, R76, R77: 100 1%; R_0805; MFGPN ERJ-P06F1000V

Connections:
/IOCONTROLLER/AI_PROT/AI_POWER_OUTPUT/SENSOR_OUT: D24.2, D25.2, D26.2, D27.2, D28.2, D29.2, D30.2, D31.2; also elsewhere on the board
unnamed: D24.1, R70.2
unnamed: D25.1, R71.2
unnamed: D26.1, R72.2
unnamed: D27.1, R73.2
unnamed: D28.1, R74.2
unnamed: D29.1, R75.2
unnamed: D30.1, R76.2
unnamed: D31.1, R77.2
unnamed: J5.1, R77.1
unnamed: J5.2, R76.1
unnamed: J5.3, R75.1
unnamed: J5.4, R74.1
unnamed: J5.5, R73.1
unnamed: J5.6, R72.1
unnamed: J5.7, R71.1
unnamed: J5.8, R70.1

Schematic: AI_POWER_INPUT.sch, Vic's IO BOARD V1.0

Parts:
D4, D13, D14, D15, D16, D17, D18, D19: BAS70-04; SOT-23; MFGPN BAS70-04-E3-08
J6: SENSOR INPUT; OSTTA084163; MFGPN OSTTA084163
R53, R54, R55, R56, R57, R58, R59, R60: 100 1%; R_0805; MFGPN ERJ-P06F1000V

Connections:
/IOCONTROLLER/AI_INPUT/AI_IN_420_1: J6.1, R60.1; also elsewhere on the board
/IOCONTROLLER/AI_INPUT/AI_IN_420_2: J6.2, R59.1; also elsewhere on the board
/IOCONTROLLER/AI_INPUT/AI_IN_420_3: J6.3, R58.1; also elsewhere on the board
/IOCONTROLLER/AI_INPUT/AI_IN_420_4: J6.4, R57.1; also elsewhere on the board
/IOCONTROLLER/AI_INPUT/AI_IN_ICD_1: J6.5, R56.1; also elsewhere on the board
/IOCONTROLLER/AI_INPUT/AI_IN_ICD_2: J6.6, R55.1; also elsewhere on the board
/IOCONTROLLER/AI_INPUT/AI_IN_ICD_3: J6.7, R54.1; also elsewhere on the board
/IOCONTROLLER/AI_INPUT/AI_IN_ICD_4: J6.8, R53.1; also elsewhere on the board
unnamed: D4.3, R53.2
unnamed: D13.3, R54.2
unnamed: D14.3, R55.2
unnamed: D15.3, R56.2
unnamed: D16.3, R57.2
unnamed: D17.3, R58.2
unnamed: D18.3, R59.2
unnamed: D19.3, R60.2
VDD_5V_PROT: D4.2, D13.2, D14.2, D15.2, D16.2, D17.2, D18.2, D19.2; also elsewhere on the board

Notes on the sheet:
BOM - 2017-06-09

Schematic: MIC5013.sch, Vic's IO BOARD V1.0

Parts:
C20: 10uF 50V; C_1206
LED1, LED12: Vf=2V; LED_0805; MFGPN LS R976-NR-1
Q1: RFD3055LE; TO-251_IPAK_Vertical; MFGPN RFD3055LE
R11, R12: 10K 1%; R_0805; MFGPN CRCW080510K0FKTA
R13: 8.2K 1%; R_0805; MFGPN RC2012F822CS
R14: 2.2K 1%; R_0805; MFGPN RMCF0805FT2K20
R15: 470 1%; R_0805; MFGPN CRCW0805470RFKEA
R16: 24K 1%; R_0805; MFGPN RMCF0805FT24K0
R17: 100 1%; R_0805; MFGPN ERJ-P06F1000V
R18: 3 1%; R_0805; MFGPN ERJ-6DQF3R0V
R19: 4.7K 1%; R_0805; MFGPN CRCW08054K70FKEA
U2: MIC5013; SOIC-8_3.9x4.9mm_Pitch1.27mm; MFGPN MIC5013YM

Connections:
/IOCONTROLLER/AI_ENABLE/RC13: R11.2, U2.1; also elsewhere on the board
/IOCONTROLLER/AI_FAULT/R0: R13.1, R14.2; also elsewhere on the board
/IOCONTROLLER/AI_PROT/AI_POWER_OUTPUT/ANALOG_OUTPUT_POWER/FAULT: R13.2, U2.8
/IOCONTROLLER/AI_PROT/AI_POWER_OUTPUT/ANALOG_OUTPUT_POWER/GATE: Q1.1, U2.6
/IOCONTROLLER/AI_PROT/AI_POWER_OUTPUT/ANALOG_OUTPUT_POWER/SENSE: R16.1, R17.2, U2.3
/IOCONTROLLER/AI_PROT/AI_POWER_OUTPUT/ANALOG_OUTPUT_POWER/THRESH: R12.1, U2.2
/IOCONTROLLER/AI_PROT/AI_POWER_OUTPUT/SENSOR_OUT: LED12.2, R18.2, U2.4; also elsewhere on the board
/IOCONTROLLER/AI_PROT/PP_AI_FAULT_LED: LED1.2; also elsewhere on the board
unnamed: LED1.1, R15.1
unnamed: LED12.1, R19.1
unnamed: Q1.3, R17.1, R18.1
VDD_24V_PROT: C20.1, Q1.2, U2.7; also elsewhere on the board

Parts of its further copies:
C25: 10uF 50V; C_1206
LED10, LED13: Vf=2V; LED_0805; MFGPN LS R976-NR-1
Q2: RFD3055LE; TO-251_IPAK_Vertical; MFGPN RFD3055LE
R36, R37: 10K 1%; R_0805; MFGPN CRCW080510K0FKTA
R38: 8.2K 1%; R_0805; MFGPN RC2012F822CS
R39: 2.2K 1%; R_0805; MFGPN RMCF0805FT2K20
R40: 470 1%; R_0805; MFGPN CRCW0805470RFKEA
R41: 24K 1%; R_0805; MFGPN RMCF0805FT24K0
R42: 100 1%; R_0805; MFGPN ERJ-P06F1000V
R43: 3 1%; R_0805; MFGPN ERJ-6DQF3R0V
R44: 4.7K 1%; R_0805; MFGPN CRCW08054K70FKEA
U6: MIC5013; SOIC-8_3.9x4.9mm_Pitch1.27mm; MFGPN MIC5013YM

Connections of its further copies:
/IOCONTROLLER/DIGITAL_OUT/DIGITAL_OUT_POWER/FAULT: R38.2, U6.8
/IOCONTROLLER/DIGITAL_OUT/DIGITAL_OUT_POWER/GATE: Q2.1, U6.6
/IOCONTROLLER/DIGITAL_OUT/DIGITAL_OUT_POWER/SENSE: R41.1, R42.2, U6.3
/IOCONTROLLER/DIGITAL_OUT/DIGITAL_OUT_POWER/THRESH: R37.1, U6.2
/IOCONTROLLER/DIGITAL_OUT/DO_POWER_OUT: LED13.2, R43.2, U6.4; also elsewhere on the board
/IOCONTROLLER/DIGITAL_OUT/PP_DO_FAULT_LED: LED10.2; also elsewhere on the board
/IOCONTROLLER/DO_ENABLE/RF5: R36.2, U6.1; also elsewhere on the board
/IOCONTROLLER/DO_FAULT/RD1: R38.1, R39.2; also elsewhere on the board
unnamed: LED10.1, R40.1
unnamed: LED13.1, R44.1
unnamed: Q2.3, R42.1, R43.1
VDD_24V_PROT: C25.1, Q2.2, U6.7; also elsewhere on the board

Notes on the sheet:
FAULT LED

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
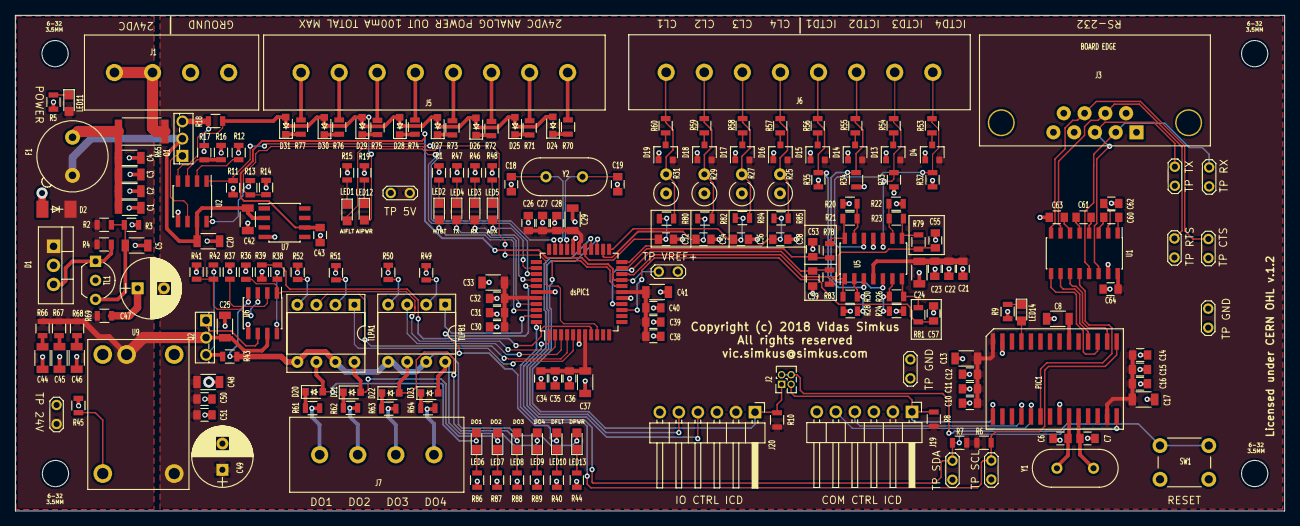
[picture p30: board VIOBOARD.kicad_pcb from above]

Board: 2 copper layers, 169.3 x 66.1 mm, 224 parts (0 on the bottom side), 146 nets.
