vic-simkus/VIOBOARD_V1_Schematics/(commit log)

2018-09-03 Initial import
    [5V_POWER_SUPPLY.sch, AI_CROWBAR.sch, AI_INPUT.sch, AI_POWER_INPUT.sch, AI_POWER_OUTPUT.sch, AI_PROT.sch, ANALOG_INPUT.sch, BBB_SHIELD.kicad_pcb]
2018-11-25 Schematics as sent to PCB manufacture.
    [BBB_SHIELD_V2-B.Cu.gbl, BBB_SHIELD_V2-B.Mask.gbs, BBB_SHIELD_V2-B.Paste.gbp, BBB_SHIELD_V2-B.SilkS.gbo, BBB_SHIELD_V2-Edge.Cuts.gm1, BBB_SHIELD_V2-F.Cu.gtl, BBB_SHIELD_V2-F.Mask.gts, BBB_SHIELD_V2-F.Paste.gtp]
2018-11-25 Libraries modified as part of the BBB cape developement.
    [5V_POWER_SUPPLY.sch, AI_INPUT.sch, AI_POWER_INPUT.sch, AI_POWER_OUTPUT.sch, COMM_PWR_DEC.sch, DIGITAL_OUT.sch, IOCONTROLLER.sch, MAX232.sch]
2019-06-23 Added a selction of custom footprints
2019-06-23 Shared schematics update.
2019-06-23 Changed to high-side switching of power supply to boards. Changed footprints to SOIC. Misc other changes.
    [BBB_SHIELD_V2.kicad_pcb, BBB_SHIELD_V2.sch, BB_HEADERS.sch, CONTROLLER.sch, FET.sch, FET_OUTPUT.sch, FILTER_CAPS.sch, POWER_SUPPLIES.sch]
2019-06-24 Added footprints for a 1206-WIDE shunt and a KSC3 surface mount tactile button.
2019-06-24 Cleaned up the crow-bar circuit schematic.
2019-06-24 Added datasheet for tactile switch.
2019-06-24 Cleaned up schematic.
    [BB_HEADERS.sch, FET.sch, POWER_SUPPLIES.sch]
2019-07-07 Added data sheet for spring terminals.
2019-07-07 Added 10 position spring terminal to footprint library from the G4 IO project. Removed outline. Added 1x6 2.54 mm pin header. Modified by removing outline.
2019-07-07 Added 1206 WIDE footprint with measurement pads. Added TO-277 diode footprint. Added MSOP-10 footprint.
2019-07-07 Cleaned up power protection sheet.
2019-07-07 Schematic cleanup and refinement.
    [BBB_SHIELD_V2.kicad_pcb, BB_HEADERS.sch, CONTROLLER.sch, FET.sch, FET_OUTPUT.sch, RS232_TRANSCEIVERS.sch]
2019-07-08 Copied the previous fabrication files.
    [BBB_SHIELD_V2-B.Cu.gbl, BBB_SHIELD_V2-B.Mask.gbs, BBB_SHIELD_V2-B.Paste.gbp, BBB_SHIELD_V2-B.SilkS.gbo, BBB_SHIELD_V2-Edge.Cuts.gm1, BBB_SHIELD_V2-F.Cu.gtl, BBB_SHIELD_V2-F.Mask.gts, BBB_SHIELD_V2-F.Paste.gtp]
2019-07-08 Part of move of old fab files. Can't seem to get git right.
    [BBB_SHIELD_V2-B.Cu.gbl, BBB_SHIELD_V2-B.Mask.gbs, BBB_SHIELD_V2-B.Paste.gbp, BBB_SHIELD_V2-B.SilkS.gbo, BBB_SHIELD_V2-Edge.Cuts.gm1, BBB_SHIELD_V2-F.Cu.gtl, BBB_SHIELD_V2-F.Mask.gts, BBB_SHIELD_V2-F.Paste.gtp]
2019-07-11 Submited to board fab.
    [BBB_SHIELD_V2-B.Cu.gbl, BBB_SHIELD_V2-B.Mask.gbs, BBB_SHIELD_V2-B.Paste.gbp, BBB_SHIELD_V2-B.SilkS.gbo, BBB_SHIELD_V2-Edge.Cuts.gm1, BBB_SHIELD_V2-F.Cu.gtl, BBB_SHIELD_V2-F.Mask.gts, BBB_SHIELD_V2-F.Paste.gtp]
2019-08-06 Rev 2 problem fixes.
    [BBB_SHIELD_V2.kicad_pcb, BBB_SHIELD_V2.sch, BB_HEADERS.sch, CONTROLLER.sch, FET.sch, FET_OUTPUT.sch, FILTER_CAPS.sch, POWER_SUPPLIES.sch]
2019-09-24 Schematics cleanup. Gerbers for the latest manufacturing release.
    [5V_POWER_SUPPLY.sch, AI_INPUT.sch, AI_POWER_INPUT.sch, AI_POWER_OUTPUT.sch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]
