vic-simkus/VIOBOARD_V1_Schematics/(notices)

Notices in the files:
VIOBOARD/AI_POWER_OUTPUT.sch:
Copyright Vidas Simkus 2018
Licensed under CERN OHL v.1.2
VIOBOARD/VIOBOARD.kicad_pcb:
Copyright 2018 Vidas Simkus
Copyright (c) 2018 Vidas Simkus
All rights reserved
BBB_SHIELD/BBB_SHIELD.kicad_pcb:
Copyright (c) 2017 Vidas Simkus
